simonvandel/AHA/README.md

# P5
