simonvandel/AHA/Report/frontpage.tex

%mainfile: master.tex
\begin{titlepage}
\begin{center}
\newcommand{\HRule}{\rule{\linewidth}{0.5mm}}

% Upper part of the page. The '~' is needed because \\
% only works if a paragraph has started.
~\\[1cm]

%\textsc{\LARGE Aalborg University}\\[1.5cm]

%\textsc{\Large Project Report}\\[0.5cm]
\vspace{2em}
% Title
\HRule \\[0.1cm]
{
\huge AHA\\\large\textsc{Automated Home Automation}\\
}

\HRule \\[1.5cm]

% Author and supervisor
\begin{minipage}{0.4\textwidth}
\begin{flushleft} \large
\textbf{Project Group}\\
\textsc{sw501e15}
\end{flushleft}
\end{minipage}
\begin{minipage}{0.4\textwidth}
\begin{flushright} \large
\textbf{Supervisor} \\
\textsc{Giovanni Bacci}
\end{flushright}
\end{minipage}

\vfill

% Bottom of the page
{\large December 21\textsuperscript{st}, 2015}

\end{center}
\end{titlepage}
