simonvandel/AHA/Report/Design/design.tex

\chapter{Design}\label{cha:design}

This chapter defines, in general terms, which subsystems are needed in order to fulfil the requirements described in the previous chapters.

\input{Design/architecture}
\input{Design/hardware}
\input{Design/ai}
\input{Design/normalizer}
\input{Design/sampler}
\input{Design/HMM}
\input{Design/reasoner}
