simonvandel/AHA/Report/Specification/PACT.tex

%mainfile: ../master.tex
\section{People, Activity, Context, and Technology Analysis}\label{sec:pact}
To establish a basis for defining the design requirements for this project and
to better understand the problem domain, a People, Activity, Context and Technology (PACT) analysis\cite{DEB} is done.

\subsection{People}\label{sub:people}
In an ideal situation the user should never be required to interact with the system. In a PACT-analysis when discussing people there are number of things that can be mentioned. In the following section we will go over a few and discuss their relevance.
Authors David Benyan, Phil Turner, Susan Turner\cite{DEB}, in BOX 22.7, propose that less than 100 ms (denoted <100 ms) is the timing required for a response to some interaction, in order for the response to be perceived by a person as being instant. This in turn means that in order for a person to perceive a response of an interaction performed by the system, as being the instant effect of the interaction, the response should be <100 ms. This knowledge poses the requirement that a full computation cycle of the system from input to response should be <100 ms.

\paragraph{Physical Abilities}
Since the system does not assume anything about the user, few physical characteristics matters. Some that might be relevant are certain disabilities. One type of disability which would matter to the system, is loss or deprecation of senses, such as blindness or hearing loss. This would impact the types of sensor data which is relevant for the system. For example, having a system which uses sound levels to determine its actions would not make sense if the system was implemented in the house of a deaf person.

\paragraph{Cognitive Abilities}
Various levels of cognitive ability encompass a wide variety of problems
when considering design. Assuming that the system is not flawless, in the
  sense that the system will perform wrong actions some of the time, how should
the system respond and inform the user of why the error happened? Another thing
to consider is how the user is presented with information regarding the status
of the system.

This is relevant to the psychological characteristics because the system needs to be designed so that, regardless of the users' technical capabilities, the users are able to use it.

Since the system is based on the usage patterns of the user, the system will not be recommended for people with personality disorders, such as schizophrenia, or people who are dependent on regularity, such as people with autism.

\subsection{Activities and Context}
The activity the system will focus on is turning on and off lights and
appliances. While this is not a time consuming task, it is done often. First the
system needs to learn users' patterns. This will not change how the user does
this activity, because the system will passively observe when and in what
context the lights or appliances are turned on.

There are a number of different
contexts when turning on appliances in a home may be relevant.
For example if the user drinks coffee in the morning, should the system then
start brewing coffee based on the time or movement in the home? Turning on
lights could also be context sensitive; for example lower levels of light
intensity in the morning or when the user is watching television.

The only time the user needs to directly interact with the system is when the system is doing something wrong. As part of the learning process the user is required to inform the system when some action is wrong. This requires one to consider how the system should present the decisions it makes to the user and allow the user to clearly define what actions were wrong.

\subsection{Technologies}
\label{sub:Technologies}
The technologies used for this type of system can be separated into three different areas, which define the purpose of technologies in the problem domain; input, output, and communication.
\subsubsection{Input}
The input can be split up into two different technology areas; sensors and general purpose interface.

The sensors are used to inform the system about the state of the problem domain. The problem domain of home automation is a diverse one since it depends on a human's habits, which is dependent on a variety of factors, such as the human's senses, their feelings, experiences and mood. Since it would be nearly impossible for a system of this type to detect a human's feelings, experiences or mood, the optimal amount of sensors is defined by being equivalent to the human senses. This as well is a very hard task to complete. Partly because it is not clear how many senses humans have; the amount varies depending on how senses are defined, and partly because each sense requires at least one sensor type. The delimitation of the problem domain makes the problem slightly simpler. Only senses used for lighting and appliance usage are needed. The senses concerning the habits of this area are found to be as follows:
\begin{itemize}
	\item Time
	\item Light intensity
	\item Location and spatial awareness
	\item Awareness of lights and appliances
  \item Awareness of the state of lights and appliances
\end{itemize}
The sensor variety needed to fully encompass the problem domain therefore needs to fulfil these areas, but variety is not everything. The perspective of the system is also different from that of the user. Since the system is stationary and the user moves around in the home, the system also need more sensors of the same type in order to emulate the users senses in all locations. This task is a bit harder to firmly put into numbers since it depends on how well the sensors operate; this could warrant some experiments, to measure the sensors' quality. Generally, it can be said that enough sensors are needed for the system to be able to detect the relevant information for the users' patterns, as well as being able to detect these information in a timely manner, such that the system can emulate the users' patterns.

\subsubsection{Output}
In all systems the output are the actuators. The actuators have to be able to mimic the actions the user are able to perform. Since the system focuses on lights and appliances it only needs to be able to:
\begin{itemize}
	\item Turn on/off the light
	\item Adjust the light up/down if possible
\end{itemize}
In the case of appliances a general list is not possible to create, since different appliances solve vastly different tasks. Luckily the appliances have well defined tasks that can be expressed formally and actuators have to be able to mimic the usage of the appliance. The actuators and sensors needed to for each specific device will be further expressed in the implementation section when needed.

\subsubsection{Communication}
As expressed earlier the system will be spread out over the home of the user. The sensors and actuators therefore need to be able to communicate with each other. The structuring of this can be found in \cref{sec:architecture}. Since the focus of this project is not on the communication, the technologies for this will follow the standards used within the established field of home automation.
