simonvandel/AHA/Report/Implementation/hardware.tex

\input{Implementation/pir}
\input{Implementation/pirExperiments}

\input{Implementation/photoResistor}
\input{Implementation/photoResistorExperiments}

\input{Implementation/ultrasonic}
