simonvandel/AHA/Report/Implementation/implementation.tex

%mainfile: ../master.tex
\chapter{Implementation}\label{part:implementation}

This chapter describes some implementations done on behalf of the architecture decision made in \cref{sec:architecture}. We will also describe and review some of the hardware employed in this project.

\input{Implementation/pir}
\input{Implementation/pirExperiments}
\input{Implementation/photoResistor}
\input{Implementation/photoResistorExperiments}
\input{Implementation/ultrasonic}
\input{Implementation/XBee/xbee}
\input{Implementation/encodingSchemes}
\input{Implementation/sensorStation}
