simonvandel/AHA/Report/Design/architecture.tex

%mainfile: ../master.tex
\section{System Architecture}\label{sec:architecture}

Overall the system has to perform three tasks.

\begin{itemize}
\item Data collection of events in the problem domain
\item Analysis of this data and inference of behavioural patterns. This is now referred to as the learning task
\item Mimic the inferred behavioural patterns learned during the learning procedure
\end{itemize}
This section discusses different architectural designs for the system.

\subsection{Variable Number of Sensors}
If the system was to support a variable number of sensors, the user has to add sensors and actuators to the system manually and inform the system about what they are, or alternatively require a technician to setup the system. This reduces usability.

If the setup is managed by the user, it is vulnerable to user mistakes, and would increase the barrier to entry. For example, consider the case where a PIR sensor is connected to the system, but the system believes the connected sensor to be a thermometer. The data received from the PIR sensor will most likely not make any sense, so the system will be based on a wrong model of the world.

\subsection{Fixed Number of Sensors}
If the system was to support a fixed number of sensors, the system is pre assembled with a fixed number of sensors and actuators and the user can simply not extend the system with more hardware. This solution does not consider the fact that all houses are different. Either there will be too many sensors in some houses, thereby consuming too much power compared to what is needed, or there will be too few sensors in some houses, meaning that the system will not be very effective and/or non existing in some rooms. This conflicts with the idea that the system should adapt to the working environment, and not vice versa.

\subsection{Monolithic System}
One possibility is to have one central processing unit that controls and reads data from all available sensors, sanitises and analyses it, decides which, if any, action to perform, and performs it via its actuators. This is illustrated in \cref{fig:monolithic_system}. A disadvantage to this architecture, is that it is not very resilient. If any part of the system crashes, the whole system is brought down with it.

\begin{figure}[htbp]
\centering
\begin{tikzpicture}
  %Nodes
  \node[squarednode] (mainController) {Sensor/actuator controller + data analyser};
  \node[squarednode] (sensor1) [above=of mainController] {Sensor 1};
  \node[squarednode] (sensor2) [below=of mainController] {Sensor 2};
  \node[squarednode] (actuator1) [right=of mainController] {Actuator 1};
  \node[squarednode] (actuator2) [left=of mainController] {Actuator 2};

  %Lines
  \path
    (mainController.north) edge (sensor1.south)
    (mainController.west) edge(actuator2.east)
    (mainController.east) edge (actuator1.west)
    (mainController.south) edge (sensor2.north);
\end{tikzpicture}
\caption[Monolithic system]{Illustration of a monolithic system. The central processing unit monitors the sensors and, at the same time, analyses the monitored sensor data.}\label{fig:monolithic_system}
\end{figure}

\subsection{Distributed System}
A second architecture tries to introduce modularity and ease of use, by distributing the sensors and actuators on several units. The system is comprised of multiple subsystems that each have a processing unit, which is aware of what sensors and actuators are connected to it. It is responsible for sanitising the sensor data and activating the actuators. They can communicate and combine their knowledge to get a complete model of the problem domain. See \cref{fig:distributed_system}.

\begin{figure}[htbp]
\centering
\begin{tikzpicture}
  %Nodes
  \node[squarednode] (controller1) {Sensor/actuator controller 1 + data analyser};
  \node[squarednode] (controller2) [right=of controller1, xshift=5em] {Sensor/actuator controller 2 + data analyser};
  \node[squarednode] (sensor1) [above=of controller1] {Sensor 1};
  \node[squarednode] (sensor2) [below=of controller1] {Sensor 2};
  \node[squarednode] (sensor3) [above=of controller2] {Sensor 3};
  \node[squarednode] (actuator1) [left=of controller1] {Actuator 1};
  \node[squarednode] (actuator2) [below=of controller2] {Actuator 2};

  %Lines
  \path
    (controller1.north) edge (sensor1.south)
    (controller1.west) edge (actuator1.east)
    (controller1.south) edge (sensor2.north)
    (controller2.north) edge (sensor3.south)
    (controller2.south) edge (actuator2.north)
    (controller1) edge[out=east,in=west,triangle 90-triangle 90] node[anchor=south] {Knowledge} (controller2);
\end{tikzpicture}
\caption[Distributed system]{Illustration of a distributed system. In this example, two controllers monitor their respective sensors and analyse the monitored data. The knowledge from the learning is shared among different controllers in the system.}\label{fig:distributed_system}
\end{figure}

The user can choose exactly the number of sensor/actuator units needed for the home. If the units are connected wirelessly, there only needs to be wired power to the unit, thereby reducing the barrier to entry.

This solution requires complex communication protocols among each individual sensor/actuator unit, in order to reliably combine their knowledge. Furthermore, the learning procedure is a complex task, see \cref{sec:functions}, that needs powerful hardware. This would mean that each unit would need to have powerful hardware, increasing power usage.

\subsection{Separated Subsystems}
A separation of data collection and actuation of tasks, and the learning procedure, is needed. In this architecture, a distributed system of small low-power processing units collect the sensor data and complete the actuation of tasks while the learning procedure is performed on a more powerful computation device.

Under this separation the system consists of three subsystems; sensor, actuator and the learning procedure. These subsystems might run on the same device. The general architecture can be seen in \cref{fig:separated_subsystems}.

\begin{figure}[htbp]
\centering
\begin{tikzpicture}
  %Nodes
  \node[squarednode] (sensorController) {Sensor controller};
  \node[squarednode] (learningController) [below right=of sensorController] {Learning controller};
  \node[squarednode] (actuatorController) [above right=of learningController] {Actuator controller};
  \node[squarednode] (sensor1) [above=of sensorController] {Sensor 1};
  \node[squarednode] (actuator1) [above=of actuatorController] {Actuator 1};

  %Lines
  \path
    (sensorController.north) edge (sensor1.south)
    (sensorController) edge[out=south,in=west] (learningController)
    (sensorController.east) edge (actuatorController.west)
    (actuatorController) edge[out=south,in=east] (learningController)
    (actuatorController.north) edge (actuator1.south);
\end{tikzpicture}
\caption[Separated system]{Illustration of a separated system. The sensor and actuator subsystem each consists of one controller, controlling one sensor and actuator respectively.}\label{fig:separated_subsystems}
\end{figure}

This solution has the advantage of allowing for variance in the number of sensors used, as well as calculating and storing the knowledge about the problem domain centrally, so there is no need to synchronise with other subsystems.

To form the complete system, some communication must take place between the subsystems. There are different possible communication schemes.

\subsubsection{Communication Scheme 1}

In this scheme, the sensor subsystem sends its sensor data to the learning subsystem to be analysed and to match for behavioural patterns. When sensor data matches a certain behavioural pattern, an action is sent to the actuator subsystem, to be immediately performed.  The scheme is illustrated in \cref{fig:separated_subsystems_scheme1}.

\begin{figure}[htbp]
\centering
\begin{tikzpicture}[->]
  %Nodes
  \node[squarednode] (sensorSubsystem) {Sensor subsystem};
  \node[squarednode] (learningSubsystem) [below right=of sensorSubsystem] {Learning subsystem};
  \node[squarednode] (actuatorSubsystem) [above right=of learningSubsystem] {Actuator subsystem};

  %Lines
  \path[-triangle 90]
    (sensorSubsystem) edge[out=south,in=west] node[anchor=east] {sensor data} (learningSubsystem)
    (learningSubsystem) edge[out=east,in=south] node[anchor=west] {action} (actuatorSubsystem);
\end{tikzpicture}
\caption[Communication scheme 1]{Illustration of communication scheme 1 for a separated system.}\label{fig:separated_subsystems_scheme1}
\end{figure}

\subsubsection{Communication Scheme 2}

This scheme is similar to scheme 1, but instead of the learning subsystem sending actions to the actuator subsystem, rules are sent. A rule specifies when an action should be performed. This rule can depend on multiple sensor values. In order for the actuator subsystem to use the rules, sensor data is needed. Therefore the sensor subsystem also sends its sensor data to the actuator subsystem. See \cref{fig:separated_subsystems_scheme2} for a visual representation.

\begin{figure}[htbp]
\centering
\begin{tikzpicture}
  %Nodes
  \node[squarednode] (sensorSubsystem) {Sensor subsystem};
  \node[squarednode] (learningSubsystem) [below right=of sensorSubsystem] {Learning subsystem};
  \node[squarednode] (actuatorSubsystem) [above right=of learningSubsystem] {Actuator subsystem};

  %Lines
  \path[-triangle 90]
  (sensorSubsystem) edge[out=south,in=west] node[anchor=east] {sensor data} (learningSubsystem)
  (sensorSubsystem) edge[out=east,in=west] node[anchor=south] {sensor data} (actuatorSubsystem)
  (learningSubsystem) edge[out=east,in=south] node[anchor=west] {rules} (actuatorSubsystem);
\end{tikzpicture}
\caption[Communication scheme 2]{Illustration of communication scheme 2 for a separated system.}\label{fig:separated_subsystems_scheme2}
\end{figure}

\subsubsection{Communication Scheme 3}

The difference between scheme 3 and 2 is that the sensor and actuator subsystems have been merged. See \cref{fig:separated_subsystems_scheme3}. This means that sensors and actuators can be connected to the same controller, reducing the latency for communicating sensor data between actuators and sensors.

\begin{figure}[htbp]
\centering
\begin{tikzpicture}
  %Nodes
  \node[squarednode] (sensorActuatorSubsystem) {Sensor/Actuator subsystem};
  \node[squarednode] (learningSubsystem) [right=of sensorActuatorSubsystem, xshift=5em] {Learning subsystem};

  %Lines
  \draw[-triangle 90, transform canvas={yshift=2mm}] (sensorActuatorSubsystem.east) -- node[anchor=south] {sensor data} (learningSubsystem.west);
  \draw[-triangle 90] (sensorActuatorSubsystem) to [out=255,in=295, looseness=8] node[anchor=north] {sensor data} (sensorActuatorSubsystem);
  \draw[-triangle 90, transform canvas={yshift=-2mm}] (learningSubsystem.west) -- node[anchor=north] {rules} (sensorActuatorSubsystem.east);
\end{tikzpicture}
\caption[Communication scheme 3]{Illustration of communication scheme 3 for a separated system.}\label{fig:separated_subsystems_scheme3}
\end{figure}

\subsubsection{Communication Scheme 4}

As in scheme 3, the sensor and actuator subsystems have been merged. The learning subsystem receives sensor data from the sensor subsystem and generates actions based on behavioural patterns. Actions are sent back to be performed. See \cref{fig:separated_subsystems_scheme4}.

\begin{figure}[htbp]
\centering
\begin{tikzpicture}
  %Nodes
  \node[squarednode] (sensorActuatorSubsystem) {Sensor/Actuator subsystem};
  \node[squarednode] (learningSubsystem) [right=of sensorActuatorSubsystem, xshift=5em] {Learning subsystem};

  %Lines
  \draw[-triangle 90, transform canvas={yshift=2mm}] (sensorActuatorSubsystem.east) -- node[anchor=south] {sensor data} (learningSubsystem.west);
  \draw[-triangle 90, transform canvas={yshift=-2mm}] (learningSubsystem.west) -- node[anchor=north] {action} (sensorActuatorSubsystem.east);
\end{tikzpicture}
\caption[Communication scheme 4]{Illustration of communication scheme 4 for a separated system.}\label{fig:separated_subsystems_scheme4}
\end{figure}

\subsubsection{Communication Scheme 5}

Sensor data is sent to the learning subsystem to be analysed for patterns. Behavioural rules are sent to the sensor subsystem. If a rules matches the current sensor data, an action is dispatched to the actuator subsystem to be immediately performed. See \cref{fig:separated_subsystems_scheme5}.

\begin{figure}[htbp]
\centering
\begin{tikzpicture}
  %Nodes
  \node[squarednode] (sensorSubsystem) {Sensor subsystem};
  \node[squarednode] (learningSubsystem) [below=of sensorSubsystem, yshift=-3em] {Learning subsystem};
  \node[squarednode] (actuatorSubsystem) [right=of sensorSubsystem, xshift=5em] {Actuator subsystem};

  %Lines
  \draw[-triangle 90, transform canvas={xshift=2mm}] (sensorSubsystem.south) -- node[anchor=west] {sensor data} (learningSubsystem.north);
  \draw[-triangle 90] (sensorSubsystem) -- node[anchor=north] {action} (actuatorSubsystem);
  \draw[-triangle 90, transform canvas={xshift=-2mm}] (learningSubsystem.north) -- node[anchor=east] {rules} (sensorSubsystem.south);
\end{tikzpicture}
\caption[Communication scheme 5]{Illustration of communication scheme 5 for a separated system.}\label{fig:separated_subsystems_scheme5}
\end{figure}

\subsection{Choice of Architecture}

Given the above architectural designs, the monolithic design lacks in reliance. The distributed design allows for greater reliance, but at the cost of the need for a complex synchronisation mechanism to make the different subsystems share their knowledge. The separated designs described above allows for greater reliance, as well as avoiding complex synchronisation between the subsystems. Therefore the separated design seems the most appropriate choice.

Many communication schemes have been discussed. This section will evaluate the schemes by comparing each of them based on the following prioritised list of properties, to find the most fitting scheme for our system.

\begin{enumerate}
\item \textbf{Number of critical communication paths.} A path is critical if the data communicated is important or has to satisfy strict real-time constraints. If a scheme has fewer critical communication paths, the system is less likely to fail, and the system will be more responsive
\item \textbf{Memory consumption on actuator and sensor subsystems.} As the actuator and sensor subsystems should be based on an embedded systems to reduce the size and power usage, the available amount of memory is limited
\item \textbf{Amount of communication.} The less time spent communicating, the more time can be spent on other activities, such as reading output of sensors. If too much time is spent on communication, it could mean that some deadlines are not met
\item \textbf{Memory consumption on learning subsystem.} In order for the learning subsystem to be able to reason about sensor data, the hardware can be more powerful, so it is not important to consider this property
\end{enumerate}

\subsubsection{Scheme 1 Evaluation}
\begin{itemize}
\item \textbf{Number of critical communication paths} This scheme has 1 critical communication path; from the learning subsystem to the actuator subsystem. If this action package is lost or slow, the system will be perceived as unresponsive or unreliable
\item \textbf{Memory consumption on actuator and sensor subsystems} Nothing needs to be stored on the actuator and sensor subsystems
\item \textbf{Amount of communication} The sensor subsystem sends sensor data very often. The learning subsystem sends actions when certain sensor value conditions are met
\item \textbf{Memory consumption on learning subsystem} The learning subsystem has to store the history of all sensor data received
\end{itemize}

\subsubsection{Scheme 2 Evaluation}
\begin{itemize}
\item \textbf{Number of critical communication paths} The path from learning to actuator path is critical in the sense that if the packet is lost, the actuator will not have received the rule, and can therefore not perform any actions. The path from sensor subsystem to actuator subsystem is already critical in the sense that the path must happen quickly in order for the system to be responsive. If the sensor data takes a long time to arrive to the actuator subsystem, the actuator will take a long time to perform an action
\item \textbf{Memory consumption on actuator and sensor subsystems} The actuator subsystem has to store rules it receives from the learning subsystem
\item \textbf{Amount of communication} The sensor subsystem to learning subsystem communication path happens often. The sensor subsystem to actuator subsystem also happens often. The learning subsystem to actuator subsystem path is only used when a new rule is generated, which should not be often
\item \textbf{Memory consumption on learning subsystem} This is the same as in scheme 1
\end{itemize}

\subsubsection{Scheme 3 Evaluation}
This has the same characteristic as scheme 2, but the critical path from sensor subsystem to actuator subsystem is more reliable as the sensors and actuators are on the same controller.

\subsubsection{Scheme 4 Evaluation}
This scheme has the same characteristics as scheme 1, but the sensor and actuator subsystems are merged.

\subsubsection{Scheme 5 Evaluation}
\begin{itemize}
\item \textbf{Number of critical communication paths} The sensor subsystem to actuator subsystem communication path is critical, because if the packet is lost or slow, it will impact the responsiveness of the system. The learning subsystem to sensor subsystem communication path is critical because if rules are lost, the system can be perceived to malfunction
\item \textbf{Memory consumption on actuator and sensor subsystems} The sensor subsystem has to store rules
\item \textbf{Amount of communication} The sensor subsystem to learning subsystem communication path occurs often. The learning subsystem to sensor subsystem communication path is only used when new rules are generated. The sensor subsystem to actuator subsystem occurs every time an action is to be performed, which could happen fairly often
\item \textbf{Memory consumption on learning subsystem} This is the same as in scheme 1
\end{itemize}

\subsubsection{Conclusion}
Scheme 4 is chosen because of the following factors.
\begin{itemize}
\item It has only one critical communication path
\item The memory consumption on the embedded systems is minimal, so no limitation on rules is imposed on the system
\end{itemize}

Rule based schemes need many communication paths, which is not preferable according the above list of properties. The sensor/actuator subsystem is referred to as the embedded subsystem hereinafter.
