simonvandel/AHA/Report/Design/hardware.tex

\section{Hardware}
As decided in \cref{sec:architecture}, the system should consist of 2 subsystems: an embedded subsystem and a learning subsystem. This section will summarise the hardware requirements for the 2 subsystems, and at the end choose which hardware is suitable choices.

\input{Design/communication}

\subsubsection{Embedded Subsystem}
The embedded subsystem consists of sensors, actuators and computational devices driving the sensors and actuators. \Cref{sec:requirements} lists some properties that the system should be able to monitor. \Cref{sec:architecture} specifies requirements for the computational devices driving the sensors and actuators. The following sections discuss different hardware components that could fulfil the requirements.
\subsubsection{Sensors/Actuators}
\paragraph{Time}
Time can be measured using a real-time clock component. This component is driven by its own battery, so it can run, regardless of whether the hardware platform it is connected to, has power.

An alternative method of keeping track of time is by using an internal clock on the hardware platform that controls the sensors and actuators. This clock will only work when the platform has power. This means that every time the hardware platform is started, the clock is reset, so the correct time has to be determined.

In the context of this system, it is important that every component of the system has the same notion of time. The time has to be synchronised between all subsystems. This is true even for the real-time clock components, as even a slight drift in time would result in different notions of time across the whole system. One can therefore argue that the persistence property of a real-time clock is not needed. An internal clock in the hardware platform is adequate, as long as it is synchronised sufficiently often with other devices in the system.

Another solution for handling time, is to record the time messages are received on the learning subsystem. That way, only one clock is used, so there is no need for synchronisation. This means that the hardware in the learning subsystem needs to have a clock.

\paragraph{Light Intensity}
To measure light intensity, photoresistors are often chosen because of their small size and low cost. These properties fit the requirements of the system very well. In this project, the \enquote{VT90N2} photoresistor is chosen, because of its availability. Further information and experiments can be found in \cref{sub:photoresistor}.

\paragraph{Spatial Awareness}
The movement of the user can be determined by a motion sensor. One example of a motion sensor is a passive infrared sensor (PIR). These type of sensors are small in size, and low in cost. The specific PIR sensor used in this project is \enquote{SEN32357P}, because of its availability. Additional information and experiments on this sensor can be found in \cref{sub:pir}.

The location of the user can be detected by a distance sensor. In this project, ultrasound distance sensors will be used. The sensor is small in size, and does not cost much. The specific component used has the part number \enquote{HC-SR04}. It was chosen because of its availability and cost. See \cref{sub:ultrasonic} for more information and experiments.

\paragraph{Awareness of Active Appliances}
To determine whether a given appliance is turned on, one can measure the number of watts it draws. A wattmeter can do this.

\paragraph{Control of Lighting and Appliances}
To control lighting and appliances, one has to have a way to conditionally allow current to flow. This can be achieved with a relay. However, in this project, relays will not be used. Instead, a simple Light Emitting Diode (LED) that can be turned on and off which will represent lighting and appliances.

\subsubsection{Embedded Platform}
\paragraph{Input/Output Pins}
The computational device, controlling the sensors and actuators, has to have sufficient number of pins for connecting said sensors and actuators.

\paragraph{Computational Performance}
The chosen architecture for the system, as described in \cref{sec:architecture}, requires the hardware to be fast enough to be able to read all sensors, encode a package, send the package to the learning subsystem, and check whether it has received any actions from the learning subsystem. All of this has to happen within 100 ms, as described in \cref{sub:people}.

\paragraph{Scheduling Options}
In \cref{sec:architecture}, the chosen architecture describes that the embedded subsystem has two functions: Control its sensors and communicate sensor data to other devices. To precisely control when actions happen on the platform, it should be possible to manually schedule tasks to run.

\paragraph{Price}
The conclusion of the analysis, as described in \cref{sec:requirements}, lists price as an important criteria.

\paragraph{Energy Efficiency}
\Cref{sec:requirements} lists energy efficiency as an important property the system should have. This means that the hardware platform controlling the sensors and actuators has to consume a small amount of energy while in use.

\paragraph{Choice of Hardware Platform}
Arduino Uno boards are chosen for controlling the sensors and actuators. The Arduino boards were already available, so no hardware was needed to be purchased. However, the Arduino Unos also fulfil all the above requirements for the hardware platform.

\subsubsection{Learning Subsystem}
The following section lists the hardware requirements for the learning subsystem.

\paragraph{Computational Performance}
The subsystem has to be powerful enough to be able to decide which actions to perform, if any, based on the sensor data received from the embedded subsystem. The deadline for this is described in \cref{sub:people}. The hardware platform used in the embedded subsystem is not powerful enough to perform these computations in reasonable time. Therefore more powerful hardware is needed.

\paragraph{Input/Output Pin Availability}
The learning subsystem has to have accessible input and output pins in order to attach radio modules to the learning computational device.

\paragraph{Choice of Hardware}
A consumer laptop is chosen as the hardware of choice for the learning subsystem because it was already available. It is estimated to be powerful enough to compute the required computations in reasonable time.
