simonvandel/AHA/Report/Design/AIArchitecture.tex

%mainfile: ../master.tex
\Cref{sec:architecture} describes the overall architecture of the system, which solves the three tasks; data collection, learning and mimicking patterns learned from the learning procedure. This section will expand on the architecture designed to perform the second and third task, that is the learning subsystem of the system.

% DRAWING
\begin{figure}[htbp]
\centering
\begin{tikzpicture}
  %Nodes
  \node[squarednode] (embeddedSubsystem) {Embedded subsystem};
  \node[squarednode] (communication) [right=of embeddedSubsystem, xshift=5em] {Communication};
  \node[squarednode] (normaliser) [right=of communication, xshift=5em] {Normaliser};
  \node[squarednode] (reasoner) [below=of embeddedSubsystem, yshift=-3em] {Reasoner};
  \node[squarednode] (modelDatabase) [below=of reasoner, yshift=-3em] {Model Database};
  \node[squarednode] (sampler) [below=of normaliser, yshift=-3em] {Sampler};
  \node[squarednode] (historyDatabase) [below=of sampler, yshift=-3em] {History Database};
  \node[squarednode] (learner) [right=of modelDatabase, xshift=5em] {Learner};

  %Lines
  \path[-triangle 90]
  (embeddedSubsystem.east) edge[transform canvas={yshift=-1em}] node[anchor=north] {sensor data} (communication.west)
  (communication.west) edge[transform canvas={yshift=1em}] node[anchor=south] {actions} (embeddedSubsystem.east)
  (communication.east) edge node[anchor=south] {snapshot, time} (normaliser)
  (normaliser.south) edge node[anchor=east,text width=6em] {normalised snapshot, time} (sampler.north)
  (sampler.south) edge node[anchor=east,text width=6em] {scope, time, actions} (historyDatabase.north)
  (historyDatabase.west) edge node[anchor=south, text width=6em] {scope, time, actions} (learner.east)
  (learner.west) edge node[anchor=south] {model} (modelDatabase.east)
  (sampler.west) edge node[anchor=south, text width=6em] {scope, time, actions} (reasoner.east)
  (modelDatabase.north) edge[transform canvas={xshift=-1em}] node[anchor=east] {model} (reasoner.south)
  (reasoner) edge[out=north,in=south] node[anchor=north] {actions} (communication)
  (reasoner.south) edge[transform canvas={xshift=1em}] node[anchor=west] {feedback} (modelDatabase.north);
\end{tikzpicture}
\caption[Learning architecture]{Overview of the modules in the learning architecture.}\label{fig:learning_architecture}
\end{figure}

As can be seen from \cref{fig:learning_architecture}, the learning subsystem contains six modules; communication, normaliser, sampler, database, learner and reasoner. The rationale of this particular architecture and its modules is explained in the following. The term \emph{snapshot} is used to describe the set of the values of all sensors at a time. For example, in a system with two sensors $S1,S2$, a snapshot at time $t$ is a particular instance of the values of the sensors, e.g. $S1=1, S2=0$.

\subsection{Communication}
The input to the learning subsystem is a stream of packets. These packets of sensor values arrive continuously, as devices from the embedded subsystem send them. The communication module handles these packets and also provides functionality to send data to devices in the learning subsystem. When sensor values arrive at the communication module, the data of the packet is encoded in the binary format described in \cref{sec:encoding}. The communication module decodes the binary data and notes the time the packet was received.

When sensor values have been received from all learning stations, the decoded sensor values and the time of arrival (the arrival time of the newest sensor value) is then sent to the normaliser. This collection of sensor values are henceforth called snapshots.

\subsection{Normaliser}
To remove noise from the sensors and to reduce the size of the problem, a normalisation pass is performed on the input. The normalisation pass is explained deeper in \cref{sec:normaliser}. The output of the normalisation is the same set of sensor values, but normalised to fit into a domain of size \emph{k}. The time of arrival is not normalised.

The normalised snapshots and the times of arrival are then fed to the sampler.

\subsection{Sampler}
This module performs three tasks:

\begin{enumerate}
\item It connects snapshots with the previous \emph{n} snapshots. The previous \emph{n} snapshots represent the history of the snapshot fed to the sampler. Together the current snapshot and its history of snapshots form a state scope
\item It calculates whether an action has occurred from the previous snapshot to the current. An action has occurred when one or more emulatable sensors have changed its value
\item It hashes the state scope
\end{enumerate}

The hashed state scopes and the calculated action, as well as the time of arrival, is now sent to two modules; the database and the reasoner.

\subsection{Database}
The database has the responsibility to store the learned model used for predicting user patterns, as well as storing samples of data observed from the sensors.

\subsection{Learner}
The responsibility of the learner is to infer the best parameters of the model. This is further described in \cref{sec:learner}. The learner will utilise the samples stored in the database. When parameters for a model has been learned, the model is stored in the database, for others to consume.

\subsection{Reasoner}
The reasoner should, based on the model retrieved from the database and the current scope, time, and actions, infer which actions the user wants performed.
