simonvandel/AHA/Report/Implementation/UltrasonicPlots/plot0angle.tex

%sensor 1
\addplot[color=red,mark=square]
  coordinates {
              (0,5)
              (1,2)
              (2,2)
              (3,3)
              (4,4)
              (5,5)
              (10,10)
              (20,20)
              (40,39)
              (80,78)
              (160,157)
              (320,313)
              (450,445)
              (570,565)
  };
  \addlegendentry{Sensor 1}
%sensor 2
\addplot[color=red,mark=star]
  coordinates {
              (0,5)
              (1,2)
              (2,2)
              (3,3)
              (4,4)
              (5,5)
              (10,10)
              (20,20)
              (40,39)
              (80,78)
              (160,157)
              (320,313)
              (450,445)
              (600,595)
  };
  \addlegendentry{Sensor 2}
%sensor 3
\addplot[color=red,mark=triangle]
  coordinates {
              (0,4)
              (1,2)
              (2,2)
              (3,3)
              (4,4)
              (5,5)
              (10,10)
              (20,20)
              (40,39)
              (80,79)
              (160,157)
              (320,315)
              (450,446)
              (570,566)
  };
  \addlegendentry{Sensor 3}
