simonvandel/AHA/Report/Implementation/UltrasonicPlots/plot0cm.tex

%sensor 1
\addplot[color=red,mark=square]
  coordinates {
              (0,5)
  };
%sensor 2
\addplot[color=red,mark=circle]
  coordinates {
              (0,5)
  };
%sensor 3
\addplot[color=red,mark=triangle]
  coordinates {
              (0,4)
  };
