simonvandel/AHA/Report/Implementation/UltrasonicPlots/plot10cm.tex

%sensor 1
\addplot[color=red,mark=square]
  coordinates {
              (10,10)
              (10,10)
              (10,9)
  };
%sensor 2
\addplot[color=red,mark=circle]
  coordinates {
              (10,10)
              (10,10)
  };
%sensor 3
\addplot[color=red,mark=triangle]
  coordinates {
              (10,10)
              (10,10)
  };
