simonvandel/AHA/Report/Implementation/UltrasonicPlots/plot160cm.tex

%sensor 1
\addplot[color=red,mark=square]
  coordinates {
              (160,157)
              (160,154)
              (160,148)
              (160,137)
  };
%sensor 2
\addplot[color=red,mark=circle]
  coordinates {
              (160,157)
  };
%sensor 3
\addplot[color=red,mark=triangle]
  coordinates {
              (160,157)
  };
