simonvandel/AHA/Report/Implementation/UltrasonicPlots/plot1cm.tex

%sensor 1
\addplot[color=red,mark=square]
  coordinates {
              (1,2)
              (1,2)
              (1,2)
              (1,2)
  };
%sensor 2
\addplot[color=red,mark=circle]
  coordinates {
              (1,2)
              (1,2)
  };
%sensor 3
\addplot[color=red,mark=triangle]
  coordinates {
              (1,2)
              (1,2)
  };
