simonvandel/AHA/Report/Implementation/UltrasonicPlots/plot20cm.tex

%sensor 1
\addplot[color=red,mark=square]
  coordinates {
              (20,20)
              (20,20)
              (20,19)
  };
%sensor 2
\addplot[color=red,mark=circle]
  coordinates {
              (20,20)
              (20,20)
  };
%sensor 3
\addplot[color=red,mark=triangle]
  coordinates {
              (20,20)
              (20,20)
  };
