simonvandel/AHA/Report/Implementation/UltrasonicPlots/plot2cm.tex

%sensor 1
\addplot[color=red,mark=square]
  coordinates {
              (2,2)
              (2,2)
              (2,3)
              (2,3)
              (2,3)
  };
%sensor 2
\addplot[color=red,mark=circle]
  coordinates {
              (2,2)
              (2,2)
  };
%sensor 3
\addplot[color=red,mark=triangle]
  coordinates {
              (2,2)
              (2,2)
  };
