simonvandel/AHA/Report/Implementation/UltrasonicPlots/plot320cm.tex

%sensor 1
\addplot[color=red,mark=square]
  coordinates {
              (320,313)
  };
%sensor 2
\addplot[color=red,mark=circle]
  coordinates {
              (320,313)
  };
%sensor 3
\addplot[color=red,mark=triangle]
  coordinates {
              (320,315)
  };
