simonvandel/AHA/Report/Implementation/UltrasonicPlots/plot3cm.tex

%sensor 1
\addplot[color=red,mark=square]
  coordinates {
              (3,3)
              (3,3)
              (3,3)
              (3,3)
              (3,4)
  };
%sensor 2
\addplot[color=red,mark=circle]
  coordinates {
              (3,3)
              (3,3)
  };
%sensor 3
\addplot[color=red,mark=triangle]
  coordinates {
              (3,3)
              (3,3)
  };
