simonvandel/AHA/Report/Implementation/UltrasonicPlots/plot40cm.tex

%sensor 1
\addplot[color=red,mark=square]
  coordinates {
              (40,39)
              (40,39)
              (40,38)
  };
%sensor 2
\addplot[color=red,mark=circle]
  coordinates {
              (40,39)
              (40,39)
  };
%sensor 3
\addplot[color=red,mark=triangle]
  coordinates {
              (40,39)
              (40,39)
  };
