simonvandel/AHA/Report/Implementation/UltrasonicPlots/plot450cm.tex

%sensor 1
\addplot[color=red,mark=square]
  coordinates {
              (450,445)
  };
%sensor 2
\addplot[color=red,mark=circle]
  coordinates {
              (450,445)
  };
%sensor 3
\addplot[color=red,mark=triangle]
  coordinates {
              (450,446)
  };
