simonvandel/AHA/Report/Implementation/UltrasonicPlots/plot4cm.tex

%sensor 1
\addplot[color=red,mark=square]
  coordinates {
              (4,4)
              (4,4)
              (4,4)
              (4,4)
              (4,4)
  };
%sensor 2
\addplot[color=red,mark=circle]
  coordinates {
              (4,4)
              (4,4)
  };
%sensor 3
\addplot[color=red,mark=triangle]
  coordinates {
              (4,4)
              (4,4)
  };
