simonvandel/AHA/Report/Implementation/UltrasonicPlots/plot570cm.tex

%sensor 1
\addplot[color=red,mark=square]
  coordinates {
              (570,565)
  };
%sensor 3
\addplot[color=red,mark=triangle]
  coordinates {
              (570,566)
  };
