simonvandel/AHA/Report/Implementation/UltrasonicPlots/plot5cm.tex

%sensor 1
\addplot[color=red,mark=square]
  coordinates {
              (5,5)
              (5,5)
              (5,5)
              (5,5)
              (5,6)
  };
%sensor 2
\addplot[color=red,mark=circle]
  coordinates {
              (5,5)
              (5,5)
  };
%sensor 3
\addplot[color=red,mark=triangle]
  coordinates {
              (5,5)
              (5,5)
  };
