simonvandel/AHA/Report/Implementation/UltrasonicPlots/plot600cm.tex

%sensor 2
\addplot[color=red,mark=circle]
  coordinates {
              (600,595)
  };
