simonvandel/AHA/Report/Implementation/UltrasonicPlots/plot80cm.tex

%sensor 1
\addplot[color=red,mark=square]
  coordinates {
              (80,78)
              (80,77)
              (80,74)
  };
%sensor 2
\addplot[color=red,mark=circle]
  coordinates {
              (80,78)
  };
%sensor 3
\addplot[color=red,mark=triangle]
  coordinates {
              (80,79)
  };
