simonvandel/AHA/ExamPresentation/slides/Rasmus.tex

\section{Embedded system implementation}
\subsection{Embedded Subsystem}
  \begin{frame}
	\frametitle{Phases in the Embedded Subsystem}
  	\begin{itemize}
  		\item poll sensors
  		\item encode
  		\item send
  		\item wait for action
        \begin{itemize}
            \item performing the action
        \end{itemize}
  	\end{itemize}
  \end{frame}

\subsubsection{Communication}
  \begin{frame}
  	\frametitle{ZigBee}
  	\begin{itemize}
  		\item ZigBee is low power, low latency, and cheap
  		\item ZigBee AT vs ZigBee API
        \begin{itemize}
            \item using ZigBee API
        \end{itemize}
  		\item difficulty making it work
        \begin{itemize}
            \item poor understanding, scarce in-depth documentation
            \item cheap hardware - low end module
            %Did we jump head first? should we jump head first in, or do more research first?
        \end{itemize}
  	\end{itemize}
  \end{frame}

\subsubsection{Encoding}
  \begin{frame}
  	\frametitle{Encoding}
  	\begin{itemize}
        \item Implementation 
    	\begin{itemize}
            \item buffer of 64 bytes
            \item keeps track of which byte, and which bit within that byte
            \item a call to the add function with parameters (4, 6):
            \begin{itemize}
                \item if enough bits are left in current byte "001000" are shifted onto the byte
                \item if not enough bits are left, available are filled and add function called recursively
                \item assume 3 bits are available in current byte shift "001" and call add on (0, 3)
            \end{itemize}            
        \end{itemize}
    \end{itemize}          	
  \end{frame}

\begin{frame}
	\frametitle{Encoding}
    \begin{itemize}
        \item implementation
		\item why did we make our own encoding?
        \begin{itemize}
            \item ZigBee interaction we can't explain
            \item flexibility, size
        \end{itemize}
    \end{itemize}
\end{frame}
