simonvandel/AHA/ExamPresentation/slides/Fuglsang.tex

\section{System Overview}
\subsection{System Specification}
\begin{frame}
	\frametitle{System Specification}
	The system should
	\begin{itemize}
	\item be able to control lighting and electronic appliances
	\item be able to learn usage patterns of users, in such a way that their usage patterns are automated
	\item be entirely wireless
	\item be conservative in its actions
	\item be able to recognise whether an action is a temporary adjustment or a permanent change in schedule
	\item minimise user interaction
	\end{itemize}
\end{frame}

\subsection{Architecture}
\begin{frame}
	\frametitle{Architecture}
  \begin{figure}[htbp]
    \centering
    \begin{tikzpicture}
        %Nodes
        \node[squarednode] (sensorActuatorSubsystem) {Embedded subsystem};
        \node[squarednode] (learningSubsystem) [right=of sensorActuatorSubsystem, xshift=5em] {Learning subsystem};

        %Lines
        \draw[-triangle 90, transform canvas={yshift=2mm}] (sensorActuatorSubsystem.east) -- node[anchor=south] {sensor data} (learningSubsystem.west);
        \draw[-triangle 90, transform canvas={yshift=-2mm}] (learningSubsystem.west) -- node[anchor=north] {action} (sensorActuatorSubsystem.east);
    \end{tikzpicture}
    \caption{General overview of the system}
  \end{figure}
\end{frame}

\begin{frame}
	\frametitle{Architecture}
  \begin{figure}[htbp]
  \centering
  \begin{tikzpicture}[scale=0.6, every node/.style={transform shape}]
    %Nodes
    \node[squarednode] (embeddedSubsystem) {Embedded subsystem};
    \node[squarednode] (communication) [right=of embeddedSubsystem, xshift=5em] {Communication};
    \node[squarednode] (normaliser) [right=of communication, xshift=5em] {Normaliser};
    \node[squarednode] (reasoner) [below=of embeddedSubsystem, yshift=-3em] {Reasoner};
    \node[squarednode] (sampler) [below=of normaliser, yshift=-3em] {Sampler};
    \node[squarednode] (learner) [below=of reasoner, yshift=-2em] {Learner};

    %Lines
    \path[-triangle 90]
    (embeddedSubsystem.east) edge[transform canvas={yshift=-0.5em}] node[anchor=north] {sensor data} (communication.west)
    (communication.west) edge[transform canvas={yshift=0.5em}] node[anchor=south] {actions} (embeddedSubsystem.east)
    (communication.east) edge node[anchor=south] {snapshot, time} (normaliser)
    (normaliser.south) edge node[anchor=east,text width=6em] {normalised snapshot, time} (sampler.north)
    (sampler) edge[out=south, in=east] node[anchor=north,text width=6em] {scope, time, actions}  (learner)
    (learner) edge[out=north, in=south, transform canvas={xshift=-1em}] node[anchor=east] {model} (reasoner)
    (sampler.west) edge node[anchor=south, text width=6em] {scope, time, actions} (reasoner.east)
    (reasoner) edge[out=north,in=south] node[anchor=north] {actions} (communication)
    (reasoner) edge[out=south,in=north, transform canvas={xshift=1em}] node[anchor=west] {feedback} (learner);
  \end{tikzpicture}
  \caption{Detailed overview of the system}
  \end{figure}
\end{frame}
