simonvandel/AHA/Report/master.tex

\input{preamble.tex}
\begin{document}
  %\listoffixmes
  \include{frontpage}
  \include{colophon}
  \pdfbookmark[0]{Title Page}{label:Titlepage}
  \include{titlepage}
	\blankpage

  \pdfbookmark[0]{\contentsname}{label:Contents}
  \setcounter{tocdepth}{2}
	\pagestyle{empty}
  % \listoffixmes
  \tableofcontents
  \listoffigures
  \begingroup
  \let\clearpage\relax
  \listoftables
  \endgroup
	\clearpage
	\pagestyle{BasicStyle}

  \pagenumbering{arabic}
  \include{preface}\thispagestyle{empty}
  \blankpage
  \include{introduction}
  \include{Analysis/analysis}
  \include{Specification/specification}
  \include{Design/design}
  \include{Implementation/implementation}
  \include{Verification/verification}
  \include{conclusion}
  \include{future}
  \pdfbookmark[0]{Bibliography}{label:Bibliography}
  \printbibliography

  \include{appendix}

\end{document}
