simonvandel/AHA/Report/preamble.tex

\synctex=1

\documentclass[a4paper,12pt,english,twoside]{report}

%%%% PACKAGES %%%%

\usepackage[table]{xcolor}
\usepackage[T1]{fontenc}
\usepackage[utf8]{inputenc} % encoding=utf8
\usepackage{fourier} % font
\usepackage{amssymb}
\usepackage{amsmath}
\usepackage{pifont}
\usepackage[english]{babel} % language support - hyphenations etc.
\usepackage{graphicx} % insertion of images
\usepackage{adjustbox}
\graphicspath{ {Images/}}
\usepackage{adjustbox}
\usepackage{listings} % source code
\usepackage{color}
%itemize spacing
\usepackage{enumitem}
\setlist[1]{itemsep=-5pt}
\usepackage[noend]{algpseudocode}
\usepackage{algorithmicx}
\usepackage{algorithm}
\usepackage{tikz}
\usepackage[simplified]{pgf-umlcd}
\usepackage{epigraph}
\usetikzlibrary{calc,arrows,positioning,shapes,snakes}

\setlength\epigraphwidth{15cm}
\setlength\epigraphrule{0pt}

\addtocontents{toc}{\setcounter{tocdepth}{1}}% Allow \section in ToC

\tikzset{
squarednode/.style={
  rectangle,
  draw=black,
  text width=8em,
  minimum height=3em,
  align=center,
  }
}
\renewcommand{\association}[6]{
\draw [umlcd style] (#1) -- (#4)
node[very near start, above]{#2}
node[very near start, above right]{#3}
node[very near end, above right]{#5}
node[very near end, below]{#6};
}

\renewcommand{\aggregation}[4]
{
\draw[umlcd style, open diamond-] (#1) -- (#4)
node[very near end, above]{#2}
node[very near end, below]{#3};
}
\renewcommand{\composition}[4]
{
\draw[umlcd style, fill=\umldrawcolor, diamond-] (#1) -- (#4)
node[very near end, above]{#2}
node[very near end, below]{#3};
}

\renewcommand{\unidirectionalAssociation}[4]{
\draw [umlcd style, -] (#1) -- (#4)
node[very near end, above]{#2}
node[very near end, below]{#3};
}

\usepackage{pgfplots} % for plotting graphs
\usepackage{textcomp}
\usepackage{siunitx}
\usepackage[inference]{semantic}
\usepackage{braket}
\usepackage{array}
\usepackage[nounderscore]{syntax}
\usepackage{gensymb}
\setlength{\grammarindent}{100pt}
\usepackage{subcaption} % subfigures

%%%%%%%flotte listings
\definecolor{dkgreen}{rgb}{0,0.6,0}
\definecolor{gray}{rgb}{0.5,0.5,0.5}
\definecolor{mauve}{rgb}{0.58,0,0.82}

\newcommand{\cmark}{\ding{51}}%Checkmark

\lstdefinelanguage{scala}{
  morekeywords={abstract,case,catch,class,def,%
    do,else,extends,false,final,finally,%
    for,if,implicit,import,match,mixin,%
    new,null,object,override,package,%
    private,protected,requires,return,sealed,%
    super,this,throw,trait,true,try,%
    type,val,var,while,with,yield},
  otherkeywords={=>,<-,<\%,<:,>:,\#,@},
  sensitive=true,
  morecomment=[l]{//},
  morecomment=[n]{/*}{*/},
  morestring=[b]",
  morestring=[b]',
  morestring=[b]"""
}

\lstdefinelanguage{TLDR}{
  keywords={else,in,for,if,return,try,var,while,let,actor,struct,receive,send,spawn},
  keywords=[2]{int,real,bool,args,char},
  keywords=[3]{->,:=,=,>,<,+,-,*,/,..,<=,>=,\#,^},
  keywords=[4]{me,true,false},
  sensitive=true,
  morecomment=[l]{//},
  morecomment=[n]{/*}{*/},
  morestring=[b]",
  morestring=[b]',
  morestring=[b]"""
}
\lstdefinestyle{TLDR}{
  language=TLDR,
  alsoletter={->,:=,:,..,+,<=,>=,*,^},
  aboveskip=2mm,
  belowskip=2mm,
	commentstyle=\color{gray},
	stringstyle=\color{string},
	keywordstyle=\color{mauve},
	keywordstyle=[2]\color{blue},
	keywordstyle=[3]\color{register},
	keywordstyle=[4]\color{orange},
	literate=%
	  {:}{{\textcolor{register}{:}}}1%
	  {0}{{{\textcolor{orange}{0}}}}1%
	  {1}{{{\textcolor{orange}{1}}}}1%
	  {2}{{{\textcolor{orange}{2}}}}1%
	  {3}{{{\textcolor{orange}{3}}}}1%
	  {4}{{{\textcolor{orange}{4}}}}1%
	  {5}{{{\textcolor{orange}{5}}}}1%
	  {6}{{{\textcolor{orange}{6}}}}1%
	  {7}{{{\textcolor{orange}{7}}}}1%
	  {8}{{{\textcolor{orange}{8}}}}1%
	  {9}{{{\textcolor{orange}{9}}}}1,
	basicstyle=\footnotesize\ttfamily,
	numbers=left,
	numberstyle=\tiny,
	numbersep=5pt,
	breaklines=true,
	showstringspaces=false,
	upquote=true,
	tabsize=4,
}

\lstdefinestyle{scala}{
  language=scala,
  aboveskip=2mm,
  belowskip=2mm,
	commentstyle=\color{comment},
	stringstyle=\color{string},
	keywordstyle=\color{instruction},
	keywordstyle=[2]\color{directive},
	keywordstyle=[3]\color{register},
	basicstyle=\footnotesize\ttfamily,
	numbers=left,
	numberstyle=\tiny,
	numbersep=5pt,
	breaklines=true,
	showstringspaces=false,
	upquote=true,
	tabsize=4,
}

\lstdefinestyle{erlang}{
  language=erlang,
  aboveskip=2mm,
  belowskip=2mm,
	commentstyle=\color{comment},
	stringstyle=\color{string},
	keywordstyle=\color{instruction},
	keywordstyle=[2]\color{directive},
	keywordstyle=[3]\color{register},
	basicstyle=\footnotesize\ttfamily,
	numbers=left,
	numberstyle=\tiny,
	numbersep=5pt,
	breaklines=true,
	showstringspaces=false,
	upquote=true,
	tabsize=4,
}

\lstdefinelanguage{fsharp}%
{morekeywords={let, new, match, with, rec, open, module, namespace, type, of, member, %
and, for, while, true, false, in, do, begin, end, fun, function, return, yield, try, %
mutable, if, then, else, cloud, async, static, use, abstract, interface, inherit, finally },
  otherkeywords={ let!, return!, do!, yield!, use!, var, from, select, where, order, by },
  keywordstyle=\color{bluekeywords},
  sensitive=true,
  basicstyle=\ttfamily,
	breaklines=true,
  xleftmargin=\parindent,
  aboveskip=\bigskipamount,
	tabsize=4,
  morecomment=[l][\color{dkgreen}]{///},
  morecomment=[l][\color{dkgreen}]{//},
  morecomment=[s][\color{dkgreen}]{{(*}{*)}},
  morestring=[b]",
  showstringspaces=false,
  literate={`}{\`}1,
  stringstyle=\color{redstrings},
}

\lstdefinestyle{fsharp}{
  language=fsharp,
  aboveskip=2mm,
  belowskip=2mm,
	commentstyle=\color{comment},
	stringstyle=\color{string},
	keywordstyle=\color{instruction},
	keywordstyle=[2]\color{directive},
	keywordstyle=[3]\color{register},
	basicstyle=\footnotesize\ttfamily,
	numbers=left,
	numberstyle=\tiny,
	numbersep=5pt,
	breaklines=true,
	showstringspaces=false,
	upquote=true,
	tabsize=4,
}

\lstdefinelanguage{llvm}{
	sensitive=true,
	alsoletter={\%},
	% comments.
	%    ; line comment
	comment=[l]{;},
	% strings.
	%    "foo"
	string=[b]{"},
	% instructions.
	%    ref: http://llvm.org/docs/LangRef.html#instruction-reference
	keywords=[1]{
add, addrspacecast, alloca, and, ashr, atomicrmw, bitcast, br, call, cmpxchg,
extractelement, extractvalue, fadd, fcmp, fdiv, fence, fmul, fpext, fptosi,
fptoui, fptrunc, frem, fsub, getelementptr, icmp, indirectbr, insertelement,
insertvalue, inttoptr, invoke, landingpad, load, lshr, mul, or, phi, ptrtoint,
resume, ret, sdiv, select, sext, shl, shufflevector, sitofp, srem, store, sub,
switch, to, trunc, udiv, uitofp, unreachable, urem, va_arg, xor, zext
	},
	% directives.
	%    ref: http://llvm.org/docs/LangRef.html
	keywords=[2]{
acq_rel, acquire, addrspace, alias, align, alignstack, alwaysinline, any,
anyregcc, appending, arcp, arm_aapcs_vfpcc, arm_aapcscc, arm_apcscc, asm,
atomic, attributes, available_externally, blockaddress, builtin, byval, c,
catch, cc, ccc, cleanup, cold, coldcc, comdat, common, constant, datalayout,
declare, default, define, dereferenceable, dllexport, dllimport, eq, exact,
exactmatch, extern_weak, external, externally_initialized, false, fast, fastcc,
filter, gc, ghccc, global, hidden, inalloca, inbounds, initialexec, inlinehint,
inreg, intel_ocl_bicc, inteldialect, internal, jumptable, largest, linkonce,
linkonce_odr, localdynamic, localexec, max, min, minsize, module, monotonic,
msp430_intrcc, musttail, naked, nand, ne, nest, ninf, nnan, noalias, nobuiltin,
nocapture, noduplicate, noduplicates, noimplicitfloat, noinline, nonlazybind,
nonnull, noredzone, noreturn, nounwind, nsw, nsz, null, nuw, oeq, oge, ogt, ole,
olt, one, opaque, optnone, optsize, ord, personality, prefix, preserve_allcc,
preserve_mostcc, private, prologue, protected, ptx_device, ptx_kernel, readnone,
readonly, release, returned, returns_twice, samesize, sanitize_address,
sanitize_memory, sanitize_thread, section, seq_cst, sge, sgt, sideeffect,
signext, singlethread, sle, slt, spir_func, spir_kernel, sret, ssp, sspreq,
sspstrong, tail, target, thread_local, triple, true, type, ueq, uge, ugt, ule,
ult, umax, umin, undef, une, unnamed_addr, uno, unordered, unwind, uselistorder,
uselistorder_bb, uwtable, volatile, weak, weak_odr, webkit_jscc, x,
x86_64_sysvcc, x86_64_win64cc, x86_fastcallcc, x86_stdcallcc, x86_thiscallcc,
x86_vectorcallcc, xchg, zeroext, zeroinitializer
	},
	% types.
	%    ref: http://llvm.org/docs/LangRef.html#type-system
	keywords=[3]{
i1, i2, i3, i4, i5, i6, i7, i8, i9, i10, i11, i12, i13, i14, i15, i16, i17, i18,
i19, i20, i21, i22, i23, i24, i25, i26, i27, i28, i29, i30, i31, i32, i33, i34,
i35, i36, i37, i38, i39, i40, i41, i42, i43, i44, i45, i46, i47, i48, i49, i50,
i51, i52, i53, i54, i55, i56, i57, i58, i59, i60, i61, i62, i63, i64, i80, i512,
void, half, float, double, fp128, x86_fp80, ppc_fp128, x86_mmx, label, metadata
	},
}

\lstdefinestyle{llvm}{
  language=llvm,
  aboveskip=2mm,
  belowskip=2mm,
	commentstyle=\color{comment},
	stringstyle=\color{string},
	keywordstyle=\color{instruction},
	keywordstyle=[2]\color{directive},
	keywordstyle=[3]\color{register},
	basicstyle=\footnotesize\ttfamily,
	numbers=left,
	numberstyle=\tiny,
	numbersep=5pt,
	breaklines=true,
	showstringspaces=false,
	upquote=true,
	tabsize=4,
}

\lstdefinelanguage{nasm}{
	sensitive=true,
	alsoletter={\%},
	% comments.
	%    ; line comment
	comment=[l]{;},
	% strings.
	%    "foo"
	%    'bar'
	string=[b]{"},
	morestring=[b]{'},
	% instructions.
	%    ref: http://www.nasm.us/doc/nasmdocb.html
	keywords=[1]{
AAA, AAD, AAM, AAS, ADC, ADCX, ADD, ADDPD, ADDPS, ADDSD, ADDSS, ADDSUBPD,
ADDSUBPS, ADOX, AESDEC, AESDECLAST, AESENC, AESENCLAST, AESIMC, AESKEYGENASSIST,
AND, ANDN, ANDNPD, ANDNPS, ANDPD, ANDPS, ARPL, BEXTR, BLCFILL, BLCI, BLCIC,
BLCMSK, BLCS, BLENDPD, BLENDPS, BLENDVPD, BLENDVPS, BLSFILL, BLSI, BLSIC,
BLSMSK, BLSR, BNDCL, BNDCN, BNDCU, BNDLDX, BNDMK, BNDMOV, BNDSTX, BOUND, BSF,
BSR, BSWAP, BT, BTC, BTR, BTS, BZHI, CALL, CBW, CDQ, CDQE, CLAC, CLC, CLD,
CLFLUSH, CLFLUSHOPT, CLGI, CLI, CLTS, CMC, CMOVA, CMOVAE, CMOVB, CMOVBE, CMOVC,
CMOVE, CMOVG, CMOVGE, CMOVL, CMOVLE, CMOVNA, CMOVNAE, CMOVNB, CMOVNBE, CMOVNC,
CMOVNE, CMOVNG, CMOVNGE, CMOVNL, CMOVNLE, CMOVNO, CMOVNP, CMOVNS, CMOVNZ, CMOVO,
CMOVP, CMOVPE, CMOVPO, CMOVS, CMOVZ, CMP, CMPEQPD, CMPEQPS, CMPEQSD, CMPEQSS,
CMPLEPD, CMPLEPS, CMPLESD, CMPLESS, CMPLTPD, CMPLTPS, CMPLTSD, CMPLTSS,
CMPNEQPD, CMPNEQPS, CMPNEQSD, CMPNEQSS, CMPNLEPD, CMPNLEPS, CMPNLESD, CMPNLESS,
CMPNLTPD, CMPNLTPS, CMPNLTSD, CMPNLTSS, CMPORDPD, CMPORDPS, CMPORDSD, CMPORDSS,
CMPPD, CMPPS, CMPSB, CMPSD, CMPSQ, CMPSS, CMPSW, CMPUNORDPD, CMPUNORDPS,
CMPUNORDSD, CMPUNORDSS, CMPXCHG, CMPXCHG16B, CMPXCHG486, CMPXCHG8B, COMISD,
COMISS, CPUID, CQO, CRC32, CVTDQ2PD, CVTDQ2PS, CVTPD2DQ, CVTPD2PI, CVTPD2PS,
CVTPI2PD, CVTPI2PS, CVTPS2DQ, CVTPS2PD, CVTPS2PI, CVTSD2SI, CVTSD2SS, CVTSI2SD,
CVTSI2SS, CVTSS2SD, CVTSS2SI, CVTTPD2DQ, CVTTPD2PI, CVTTPS2DQ, CVTTPS2PI,
CVTTSD2SI, CVTTSS2SI, CWD, CWDE, DAA, DAS, DEC, DIV, DIVPD, DIVPS, DIVSD, DIVSS,
DMINT, DPPD, DPPS, EMMS, ENTER, EXTRACTPS, EXTRQ, F2XM1, FABS, FADD, FADDP,
FBLD, FBSTP, FCHS, FCLEX, FCMOVB, FCMOVBE, FCMOVE, FCMOVNB, FCMOVNBE, FCMOVNE,
FCMOVNU, FCMOVU, FCOM, FCOMI, FCOMIP, FCOMP, FCOMPP, FCOS, FDECSTP, FDISI, FDIV,
FDIVP, FDIVR, FDIVRP, FEMMS, FENI, FFREE, FFREEP, FIADD, FICOM, FICOMP, FIDIV,
FIDIVR, FILD, FIMUL, FINCSTP, FINIT, FIST, FISTP, FISTTP, FISUB, FISUBR, FLD,
FLD1, FLDCW, FLDENV, FLDL2E, FLDL2T, FLDLG2, FLDLN2, FLDPI, FLDZ, FMUL, FMULP,
FNCLEX, FNDISI, FNENI, FNINIT, FNOP, FNSAVE, FNSTCW, FNSTENV, FNSTSW, FPATAN,
FPREM, FPREM1, FPTAN, FRNDINT, FRSTOR, FSAVE, FSCALE, FSETPM, FSIN, FSINCOS,
FSQRT, FST, FSTCW, FSTENV, FSTP, FSTSW, FSUB, FSUBP, FSUBR, FSUBRP, FTST, FUCOM,
FUCOMI, FUCOMIP, FUCOMP, FUCOMPP, FWAIT, FXAM, FXCH, FXRSTOR, FXRSTOR64, FXSAVE,
FXSAVE64, FXTRACT, FYL2X, FYL2XP1, GETSEC, HADDPD, HADDPS, HLT, HSUBPD, HSUBPS,
IBTS, ICEBP, IDIV, IMUL, IN, INC, INCBIN, INSB, INSD, INSERTPS, INSERTQ, INSW,
INT, INT01, INT03, INT1, INT3, INTO, INVD, INVEPT, INVLPG, INVLPGA, INVPCID,
INVVPID, IRET, IRETD, IRETQ, IRETW, JA, JAE, JB, JBE, JC, JCXZ, JE, JECXZ, JG,
JGE, JL, JLE, JMP, JMPE, JNA, JNAE, JNB, JNBE, JNC, JNE, JNG, JNGE, JNL, JNLE,
JNO, JNP, JNS, JNZ, JO, JP, JPE, JPO, JRCXZ, JS, JZ, KADDB, KADDD, KADDQ, KADDW,
KANDB, KANDD, KANDNB, KANDND, KANDNQ, KANDNW, KANDQ, KANDW, KMOVB, KMOVD, KMOVQ,
KMOVW, KNOTB, KNOTD, KNOTQ, KNOTW, KORB, KORD, KORQ, KORTESTB, KORTESTD,
KORTESTQ, KORTESTW, KORW, KSHIFTLB, KSHIFTLD, KSHIFTLQ, KSHIFTLW, KSHIFTRB,
KSHIFTRD, KSHIFTRQ, KSHIFTRW, KTESTB, KTESTD, KTESTQ, KTESTW, KUNPCKBW,
KUNPCKDQ, KUNPCKWD, KXNORB, KXNORD, KXNORQ, KXNORW, KXORB, KXORD, KXORQ, KXORW,
LAHF, LAR, LDDQU, LDMXCSR, LDS, LEA, LEAVE, LES, LFENCE, LFS, LGDT, LGS, LIDT,
LLDT, LLWPCB, LMSW, LOADALL, LOADALL286, LODSB, LODSD, LODSQ, LODSW, LOOP,
LOOPE, LOOPNE, LOOPNZ, LOOPZ, LSL, LSS, LTR, LWPINS, LWPVAL, LZCNT, MASKMOVDQU,
MASKMOVQ, MAXPD, MAXPS, MAXSD, MAXSS, MFENCE, MINPD, MINPS, MINSD, MINSS,
MONITOR, MONTMUL, MOV, MOVAPD, MOVAPS, MOVBE, MOVD, MOVDDUP, MOVDQ2Q, MOVDQA,
MOVDQU, MOVHLPS, MOVHPD, MOVHPS, MOVLHPS, MOVLPD, MOVLPS, MOVMSKPD, MOVMSKPS,
MOVNTDQ, MOVNTDQA, MOVNTI, MOVNTPD, MOVNTPS, MOVNTQ, MOVNTSD, MOVNTSS, MOVQ,
MOVQ2DQ, MOVSB, MOVSD, MOVSHDUP, MOVSLDUP, MOVSQ, MOVSS, MOVSW, MOVSX, MOVSXD,
MOVUPD, MOVUPS, MOVZX, MPSADBW, MUL, MULPD, MULPS, MULSD, MULSS, MULX, MWAIT,
NEG, NOP, NOT, OR, ORPD, ORPS, OUT, OUTSB, OUTSD, OUTSW, PABSB, PABSD, PABSW,
PACKSSDW, PACKSSWB, PACKUSDW, PACKUSWB, PADDB, PADDD, PADDQ, PADDSB, PADDSIW,
PADDSW, PADDUSB, PADDUSW, PADDW, PALIGNR, PAND, PANDN, PAUSE, PAVEB, PAVGB,
PAVGUSB, PAVGW, PBLENDVB, PBLENDW, PCLMULHQHQDQ, PCLMULHQLQDQ, PCLMULLQHQDQ,
PCLMULLQLQDQ, PCLMULQDQ, PCMPEQB, PCMPEQD, PCMPEQQ, PCMPEQW, PCMPESTRI,
PCMPESTRM, PCMPGTB, PCMPGTD, PCMPGTQ, PCMPGTW, PCMPISTRI, PCMPISTRM, PDEP,
PDISTIB, PEXT, PEXTRB, PEXTRD, PEXTRQ, PEXTRW, PF2ID, PF2IW, PFACC, PFADD,
PFCMPEQ, PFCMPGE, PFCMPGT, PFMAX, PFMIN, PFMUL, PFNACC, PFPNACC, PFRCP,
PFRCPIT1, PFRCPIT2, PFRCPV, PFRSQIT1, PFRSQRT, PFRSQRTV, PFSUB, PFSUBR, PHADDD,
PHADDSW, PHADDW, PHMINPOSUW, PHSUBD, PHSUBSW, PHSUBW, PI2FD, PI2FW, PINSRB,
PINSRD, PINSRQ, PINSRW, PMACHRIW, PMADDUBSW, PMADDWD, PMAGW, PMAXSB, PMAXSD,
PMAXSW, PMAXUB, PMAXUD, PMAXUW, PMINSB, PMINSD, PMINSW, PMINUB, PMINUD, PMINUW,
PMOVMSKB, PMOVSXBD, PMOVSXBQ, PMOVSXBW, PMOVSXDQ, PMOVSXWD, PMOVSXWQ, PMOVZXBD,
PMOVZXBQ, PMOVZXBW, PMOVZXDQ, PMOVZXWD, PMOVZXWQ, PMULDQ, PMULHRIW, PMULHRSW,
PMULHRWA, PMULHRWC, PMULHUW, PMULHW, PMULLD, PMULLW, PMULUDQ, PMVGEZB, PMVLZB,
PMVNZB, PMVZB, POP, POPA, POPAD, POPAW, POPCNT, POPF, POPFD, POPFQ, POPFW, POR,
PREFETCH, PREFETCHNTA, PREFETCHT0, PREFETCHT1, PREFETCHT2, PREFETCHW,
PREFETCHWT1, PSADBW, PSHUFB, PSHUFD, PSHUFHW, PSHUFLW, PSHUFW, PSIGNB, PSIGND,
PSIGNW, PSLLD, PSLLDQ, PSLLQ, PSLLW, PSRAD, PSRAW, PSRLD, PSRLDQ, PSRLQ, PSRLW,
PSUBB, PSUBD, PSUBQ, PSUBSB, PSUBSIW, PSUBSW, PSUBUSB, PSUBUSW, PSUBW, PSWAPD,
PTEST, PUNPCKHBW, PUNPCKHDQ, PUNPCKHQDQ, PUNPCKHWD, PUNPCKLBW, PUNPCKLDQ,
PUNPCKLQDQ, PUNPCKLWD, PUSH, PUSHA, PUSHAD, PUSHAW, PUSHF, PUSHFD, PUSHFQ,
PUSHFW, PXOR, RCL, RCPPS, RCPSS, RCR, RDFSBASE, RDGSBASE, RDM, RDMSR, RDPMC,
RDRAND, RDSEED, RDSHR, RDTSC, RDTSCP, RET, RETF, RETN, ROL, ROR, RORX, ROUNDPD,
ROUNDPS, ROUNDSD, ROUNDSS, RSDC, RSLDT, RSM, RSQRTPS, RSQRTSS, RSTS, SAHF, SAL,
SALC, SAR, SARX, SBB, SCASB, SCASD, SCASQ, SCASW, SETA, SETAE, SETB, SETBE,
SETC, SETE, SETG, SETGE, SETL, SETLE, SETNA, SETNAE, SETNB, SETNBE, SETNC,
SETNE, SETNG, SETNGE, SETNL, SETNLE, SETNO, SETNP, SETNS, SETNZ, SETO, SETP,
SETPE, SETPO, SETS, SETZ, SFENCE, SGDT, SHA1MSG1, SHA1MSG2, SHA1NEXTE,
SHA1RNDS4, SHA256MSG1, SHA256MSG2, SHA256RNDS2, SHL, SHLD, SHLX, SHR, SHRD,
SHRX, SHUFPD, SHUFPS, SIDT, SKINIT, SLDT, SLWPCB, SMI, SMINT, SMINTOLD, SMSW,
SQRTPD, SQRTPS, SQRTSD, SQRTSS, STAC, STC, STD, STGI, STI, STMXCSR, STOSB,
STOSD, STOSQ, STOSW, STR, SUB, SUBPD, SUBPS, SUBSD, SUBSS, SVDC, SVLDT, SVTS,
SWAPGS, SYSCALL, SYSENTER, SYSEXIT, SYSRET, T1MSKC, TEST, TZCNT, TZMSK, UCOMISD,
UCOMISS, UD0, UD1, UD2, UD2A, UD2B, UMOV, UNPCKHPD, UNPCKHPS, UNPCKLPD,
UNPCKLPS, VADDPD, VADDPS, VADDSD, VADDSS, VADDSUBPD, VADDSUBPS, VAESDEC,
VAESDECLAST, VAESENC, VAESENCLAST, VAESIMC, VAESKEYGENASSIST, VALIGND, VALIGNQ,
VANDNPD, VANDNPS, VANDPD, VANDPS, VBLENDMPD, VBLENDMPS, VBLENDPD, VBLENDPS,
VBLENDVPD, VBLENDVPS, VBROADCASTF128, VBROADCASTF32X2, VBROADCASTF32X4,
VBROADCASTF32X8, VBROADCASTF64X2, VBROADCASTF64X4, VBROADCASTI128,
VBROADCASTI32X2, VBROADCASTI32X4, VBROADCASTI32X8, VBROADCASTI64X2,
VBROADCASTI64X4, VBROADCASTSD, VBROADCASTSS, VCMPEQPD, VCMPEQPS, VCMPEQSD,
VCMPEQSS, VCMPFALSEPD, VCMPFALSEPS, VCMPFALSESD, VCMPFALSESS, VCMPGEPD,
VCMPGEPS, VCMPGESD, VCMPGESS, VCMPGTPD, VCMPGTPS, VCMPGTSD, VCMPGTSS, VCMPLEPD,
VCMPLEPS, VCMPLESD, VCMPLESS, VCMPLTPD, VCMPLTPS, VCMPLTSD, VCMPLTSS, VCMPNEQPD,
VCMPNEQPS, VCMPNEQSD, VCMPNEQSS, VCMPNGEPD, VCMPNGEPS, VCMPNGESD, VCMPNGESS,
VCMPNGTPD, VCMPNGTPS, VCMPNGTSD, VCMPNGTSS, VCMPNLEPD, VCMPNLEPS, VCMPNLESD,
VCMPNLESS, VCMPNLTPD, VCMPNLTPS, VCMPNLTSD, VCMPNLTSS, VCMPORDPD, VCMPORDPS,
VCMPORDSD, VCMPORDSS, VCMPPD, VCMPPS, VCMPSD, VCMPSS, VCMPTRUEPD, VCMPTRUEPS,
VCMPTRUESD, VCMPTRUESS, VCMPUNORDPD, VCMPUNORDPS, VCMPUNORDSD, VCMPUNORDSS,
VCOMISD, VCOMISS, VCOMPRESSPD, VCOMPRESSPS, VCVTDQ2PD, VCVTDQ2PS, VCVTPD2DQ,
VCVTPD2PS, VCVTPD2QQ, VCVTPD2UDQ, VCVTPD2UQQ, VCVTPH2PS, VCVTPS2DQ, VCVTPS2PD,
VCVTPS2PH, VCVTPS2QQ, VCVTPS2UDQ, VCVTPS2UQQ, VCVTQQ2PD, VCVTQQ2PS, VCVTSD2SI,
VCVTSD2SS, VCVTSD2USI, VCVTSI2SD, VCVTSI2SS, VCVTSS2SD, VCVTSS2SI, VCVTSS2USI,
VCVTTPD2DQ, VCVTTPD2QQ, VCVTTPD2UDQ, VCVTTPD2UQQ, VCVTTPS2DQ, VCVTTPS2QQ,
VCVTTPS2UDQ, VCVTTPS2UQQ, VCVTTSD2SI, VCVTTSD2USI, VCVTTSS2SI, VCVTTSS2USI,
VCVTUDQ2PD, VCVTUDQ2PS, VCVTUQQ2PD, VCVTUQQ2PS, VCVTUSI2SD, VCVTUSI2SS,
VDBPSADBW, VDIVPD, VDIVPS, VDIVSD, VDIVSS, VDPPD, VDPPS, VERR, VERW, VEXP2PD,
VEXP2PS, VEXPANDPD, VEXPANDPS, VEXTRACTF128, VEXTRACTF32X4, VEXTRACTF32X8,
VEXTRACTF64X2, VEXTRACTF64X4, VEXTRACTI128, VEXTRACTI32X4, VEXTRACTI32X8,
VEXTRACTI64X2, VEXTRACTI64X4, VEXTRACTPS, VFIXUPIMMPD, VFIXUPIMMPS, VFIXUPIMMSD,
VFIXUPIMMSS, VFMADD123PD, VFMADD123PS, VFMADD123SD, VFMADD123SS, VFMADD132PD,
VFMADD132PS, VFMADD132SD, VFMADD132SS, VFMADD213PD, VFMADD213PS, VFMADD213SD,
VFMADD213SS, VFMADD231PD, VFMADD231PS, VFMADD231SD, VFMADD231SS, VFMADD312PD,
VFMADD312PS, VFMADD312SD, VFMADD312SS, VFMADD321PD, VFMADD321PS, VFMADD321SD,
VFMADD321SS, VFMADDPD, VFMADDPS, VFMADDSD, VFMADDSS, VFMADDSUB123PD,
VFMADDSUB123PS, VFMADDSUB132PD, VFMADDSUB132PS, VFMADDSUB213PD, VFMADDSUB213PS,
VFMADDSUB231PD, VFMADDSUB231PS, VFMADDSUB312PD, VFMADDSUB312PS, VFMADDSUB321PD,
VFMADDSUB321PS, VFMADDSUBPD, VFMADDSUBPS, VFMSUB123PD, VFMSUB123PS, VFMSUB123SD,
VFMSUB123SS, VFMSUB132PD, VFMSUB132PS, VFMSUB132SD, VFMSUB132SS, VFMSUB213PD,
VFMSUB213PS, VFMSUB213SD, VFMSUB213SS, VFMSUB231PD, VFMSUB231PS, VFMSUB231SD,
VFMSUB231SS, VFMSUB312PD, VFMSUB312PS, VFMSUB312SD, VFMSUB312SS, VFMSUB321PD,
VFMSUB321PS, VFMSUB321SD, VFMSUB321SS, VFMSUBADD123PD, VFMSUBADD123PS,
VFMSUBADD132PD, VFMSUBADD132PS, VFMSUBADD213PD, VFMSUBADD213PS, VFMSUBADD231PD,
VFMSUBADD231PS, VFMSUBADD312PD, VFMSUBADD312PS, VFMSUBADD321PD, VFMSUBADD321PS,
VFMSUBADDPD, VFMSUBADDPS, VFMSUBPD, VFMSUBPS, VFMSUBSD, VFMSUBSS, VFNMADD123PD,
VFNMADD123PS, VFNMADD123SD, VFNMADD123SS, VFNMADD132PD, VFNMADD132PS,
VFNMADD132SD, VFNMADD132SS, VFNMADD213PD, VFNMADD213PS, VFNMADD213SD,
VFNMADD213SS, VFNMADD231PD, VFNMADD231PS, VFNMADD231SD, VFNMADD231SS,
VFNMADD312PD, VFNMADD312PS, VFNMADD312SD, VFNMADD312SS, VFNMADD321PD,
VFNMADD321PS, VFNMADD321SD, VFNMADD321SS, VFNMADDPD, VFNMADDPS, VFNMADDSD,
VFNMADDSS, VFNMSUB123PD, VFNMSUB123PS, VFNMSUB123SD, VFNMSUB123SS, VFNMSUB132PD,
VFNMSUB132PS, VFNMSUB132SD, VFNMSUB132SS, VFNMSUB213PD, VFNMSUB213PS,
VFNMSUB213SD, VFNMSUB213SS, VFNMSUB231PD, VFNMSUB231PS, VFNMSUB231SD,
VFNMSUB231SS, VFNMSUB312PD, VFNMSUB312PS, VFNMSUB312SD, VFNMSUB312SS,
VFNMSUB321PD, VFNMSUB321PS, VFNMSUB321SD, VFNMSUB321SS, VFNMSUBPD, VFNMSUBPS,
VFNMSUBSD, VFNMSUBSS, VFPCLASSPD, VFPCLASSPS, VFPCLASSSD, VFPCLASSSS, VFRCZPD,
VFRCZPS, VFRCZSD, VFRCZSS, VGATHERDPD, VGATHERDPS, VGATHERPF0DPD, VGATHERPF0DPS,
VGATHERPF0QPD, VGATHERPF0QPS, VGATHERPF1DPD, VGATHERPF1DPS, VGATHERPF1QPD,
VGATHERPF1QPS, VGATHERQPD, VGATHERQPS, VGETEXPPD, VGETEXPPS, VGETEXPSD,
VGETEXPSS, VGETMANTPD, VGETMANTPS, VGETMANTSD, VGETMANTSS, VHADDPD, VHADDPS,
VHSUBPD, VHSUBPS, VINSERTF128, VINSERTF32X4, VINSERTF32X8, VINSERTF64X2,
VINSERTF64X4, VINSERTI128, VINSERTI32X4, VINSERTI32X8, VINSERTI64X2,
VINSERTI64X4, VINSERTPS, VLDDQU, VLDMXCSR, VLDQQU, VMASKMOVDQU, VMASKMOVPD,
VMASKMOVPS, VMAXPD, VMAXPS, VMAXSD, VMAXSS, VMCALL, VMCLEAR, VMFUNC, VMINPD,
VMINPS, VMINSD, VMINSS, VMLAUNCH, VMLOAD, VMMCALL, VMOVAPD, VMOVAPS, VMOVD,
VMOVDDUP, VMOVDQA, VMOVDQA32, VMOVDQA64, VMOVDQU, VMOVDQU16, VMOVDQU32,
VMOVDQU64, VMOVDQU8, VMOVHLPS, VMOVHPD, VMOVHPS, VMOVLHPS, VMOVLPD, VMOVLPS,
VMOVMSKPD, VMOVMSKPS, VMOVNTDQ, VMOVNTDQA, VMOVNTPD, VMOVNTPS, VMOVNTQQ, VMOVQ,
VMOVQQA, VMOVQQU, VMOVSD, VMOVSHDUP, VMOVSLDUP, VMOVSS, VMOVUPD, VMOVUPS,
VMPSADBW, VMPTRLD, VMPTRST, VMREAD, VMRESUME, VMRUN, VMSAVE, VMULPD, VMULPS,
VMULSD, VMULSS, VMWRITE, VMXOFF, VMXON, VORPD, VORPS, VPABSB, VPABSD, VPABSQ,
VPABSW, VPACKSSDW, VPACKSSWB, VPACKUSDW, VPACKUSWB, VPADDB, VPADDD, VPADDQ,
VPADDSB, VPADDSW, VPADDUSB, VPADDUSW, VPADDW, VPALIGNR, VPAND, VPANDD, VPANDN,
VPANDND, VPANDNQ, VPANDQ, VPAVGB, VPAVGW, VPBLENDD, VPBLENDMB, VPBLENDMD,
VPBLENDMQ, VPBLENDMW, VPBLENDVB, VPBLENDW, VPBROADCASTB, VPBROADCASTD,
VPBROADCASTMB2Q, VPBROADCASTMW2D, VPBROADCASTQ, VPBROADCASTW, VPCLMULHQHQDQ,
VPCLMULHQLQDQ, VPCLMULLQHQDQ, VPCLMULLQLQDQ, VPCLMULQDQ, VPCMOV, VPCMPB, VPCMPD,
VPCMPEQB, VPCMPEQD, VPCMPEQQ, VPCMPEQW, VPCMPESTRI, VPCMPESTRM, VPCMPGTB,
VPCMPGTD, VPCMPGTQ, VPCMPGTW, VPCMPISTRI, VPCMPISTRM, VPCMPQ, VPCMPUB, VPCMPUD,
VPCMPUQ, VPCMPUW, VPCMPW, VPCOMB, VPCOMD, VPCOMPRESSD, VPCOMPRESSQ, VPCOMQ,
VPCOMUB, VPCOMUD, VPCOMUQ, VPCOMUW, VPCOMW, VPCONFLICTD, VPCONFLICTQ,
VPERM2F128, VPERM2I128, VPERMB, VPERMD, VPERMI2B, VPERMI2D, VPERMI2PD,
VPERMI2PS, VPERMI2Q, VPERMI2W, VPERMILPD, VPERMILPS, VPERMPD, VPERMPS, VPERMQ,
VPERMT2B, VPERMT2D, VPERMT2PD, VPERMT2PS, VPERMT2Q, VPERMT2W, VPERMW, VPEXPANDD,
VPEXPANDQ, VPEXTRB, VPEXTRD, VPEXTRQ, VPEXTRW, VPGATHERDD, VPGATHERDQ,
VPGATHERQD, VPGATHERQQ, VPHADDBD, VPHADDBQ, VPHADDBW, VPHADDD, VPHADDDQ,
VPHADDSW, VPHADDUBD, VPHADDUBQ, VPHADDUBW, VPHADDUDQ, VPHADDUWD, VPHADDUWQ,
VPHADDW, VPHADDWD, VPHADDWQ, VPHMINPOSUW, VPHSUBBW, VPHSUBD, VPHSUBDQ, VPHSUBSW,
VPHSUBW, VPHSUBWD, VPINSRB, VPINSRD, VPINSRQ, VPINSRW, VPLZCNTD, VPLZCNTQ,
VPMACSDD, VPMACSDQH, VPMACSDQL, VPMACSSDD, VPMACSSDQH, VPMACSSDQL, VPMACSSWD,
VPMACSSWW, VPMACSWD, VPMACSWW, VPMADCSSWD, VPMADCSWD, VPMADD52HUQ, VPMADD52LUQ,
VPMADDUBSW, VPMADDWD, VPMASKMOVD, VPMASKMOVQ, VPMAXSB, VPMAXSD, VPMAXSQ,
VPMAXSW, VPMAXUB, VPMAXUD, VPMAXUQ, VPMAXUW, VPMINSB, VPMINSD, VPMINSQ, VPMINSW,
VPMINUB, VPMINUD, VPMINUQ, VPMINUW, VPMOVB2M, VPMOVD2M, VPMOVDB, VPMOVDW,
VPMOVM2B, VPMOVM2D, VPMOVM2Q, VPMOVM2W, VPMOVMSKB, VPMOVQ2M, VPMOVQB, VPMOVQD,
VPMOVQW, VPMOVSDB, VPMOVSDW, VPMOVSQB, VPMOVSQD, VPMOVSQW, VPMOVSWB, VPMOVSXBD,
VPMOVSXBQ, VPMOVSXBW, VPMOVSXDQ, VPMOVSXWD, VPMOVSXWQ, VPMOVUSDB, VPMOVUSDW,
VPMOVUSQB, VPMOVUSQD, VPMOVUSQW, VPMOVUSWB, VPMOVW2M, VPMOVWB, VPMOVZXBD,
VPMOVZXBQ, VPMOVZXBW, VPMOVZXDQ, VPMOVZXWD, VPMOVZXWQ, VPMULDQ, VPMULHRSW,
VPMULHUW, VPMULHW, VPMULLD, VPMULLQ, VPMULLW, VPMULTISHIFTQB, VPMULUDQ, VPOR,
VPORD, VPORQ, VPPERM, VPROLD, VPROLQ, VPROLVD, VPROLVQ, VPRORD, VPRORQ, VPRORVD,
VPRORVQ, VPROTB, VPROTD, VPROTQ, VPROTW, VPSADBW, VPSCATTERDD, VPSCATTERDQ,
VPSCATTERQD, VPSCATTERQQ, VPSHAB, VPSHAD, VPSHAQ, VPSHAW, VPSHLB, VPSHLD,
VPSHLQ, VPSHLW, VPSHUFB, VPSHUFD, VPSHUFHW, VPSHUFLW, VPSIGNB, VPSIGND, VPSIGNW,
VPSLLD, VPSLLDQ, VPSLLQ, VPSLLVD, VPSLLVQ, VPSLLVW, VPSLLW, VPSRAD, VPSRAQ,
VPSRAVD, VPSRAVQ, VPSRAVW, VPSRAW, VPSRLD, VPSRLDQ, VPSRLQ, VPSRLVD, VPSRLVQ,
VPSRLVW, VPSRLW, VPSUBB, VPSUBD, VPSUBQ, VPSUBSB, VPSUBSW, VPSUBUSB, VPSUBUSW,
VPSUBW, VPTERNLOGD, VPTERNLOGQ, VPTEST, VPTESTMB, VPTESTMD, VPTESTMQ, VPTESTMW,
VPTESTNMB, VPTESTNMD, VPTESTNMQ, VPTESTNMW, VPUNPCKHBW, VPUNPCKHDQ, VPUNPCKHQDQ,
VPUNPCKHWD, VPUNPCKLBW, VPUNPCKLDQ, VPUNPCKLQDQ, VPUNPCKLWD, VPXOR, VPXORD,
VPXORQ, VRANGEPD, VRANGEPS, VRANGESD, VRANGESS, VRCP14PD, VRCP14PS, VRCP14SD,
VRCP14SS, VRCP28PD, VRCP28PS, VRCP28SD, VRCP28SS, VRCPPS, VRCPSS, VREDUCEPD,
VREDUCEPS, VREDUCESD, VREDUCESS, VRNDSCALEPD, VRNDSCALEPS, VRNDSCALESD,
VRNDSCALESS, VROUNDPD, VROUNDPS, VROUNDSD, VROUNDSS, VRSQRT14PD, VRSQRT14PS,
VRSQRT14SD, VRSQRT14SS, VRSQRT28PD, VRSQRT28PS, VRSQRT28SD, VRSQRT28SS,
VRSQRTPS, VRSQRTSS, VSCALEFPD, VSCALEFPS, VSCALEFSD, VSCALEFSS, VSCATTERDPD,
VSCATTERDPS, VSCATTERPF0DPD, VSCATTERPF0DPS, VSCATTERPF0QPD, VSCATTERPF0QPS,
VSCATTERPF1DPD, VSCATTERPF1DPS, VSCATTERPF1QPD, VSCATTERPF1QPS, VSCATTERQPD,
VSCATTERQPS, VSHUFF32X4, VSHUFF64X2, VSHUFI32X4, VSHUFI64X2, VSHUFPD, VSHUFPS,
VSQRTPD, VSQRTPS, VSQRTSD, VSQRTSS, VSTMXCSR, VSUBPD, VSUBPS, VSUBSD, VSUBSS,
VTESTPD, VTESTPS, VUCOMISD, VUCOMISS, VUNPCKHPD, VUNPCKHPS, VUNPCKLPD,
VUNPCKLPS, VXORPD, VXORPS, VZEROALL, VZEROUPPER, WBINVD, WRFSBASE, WRGSBASE,
WRMSR, WRSHR, XABORT, XADD, XBEGIN, XBTS, XCHG, XCRYPTCBC, XCRYPTCFB, XCRYPTCTR,
XCRYPTECB, XCRYPTOFB, XEND, XGETBV, XLAT, XLATB, XOR, XORPD, XORPS, XRSTOR,
XRSTOR64, XRSTORS, XRSTORS64, XSAVE, XSAVE64, XSAVEC, XSAVEC64, XSAVEOPT,
XSAVEOPT64, XSAVES, XSAVES64, XSETBV, XSHA1, XSHA256, XSTORE, XTEST,
aaa, aad, aam, aas, adc, adcx, add, addpd, addps, addsd, addss, addsubpd,
addsubps, adox, aesdec, aesdeclast, aesenc, aesenclast, aesimc, aeskeygenassist,
and, andn, andnpd, andnps, andpd, andps, arpl, bextr, blcfill, blci, blcic,
blcmsk, blcs, blendpd, blendps, blendvpd, blendvps, blsfill, blsi, blsic,
blsmsk, blsr, bndcl, bndcn, bndcu, bndldx, bndmk, bndmov, bndstx, bound, bsf,
bsr, bswap, bt, btc, btr, bts, bzhi, call, callq, cbw, cdq, cdqe, clac, clc, cld,
clflush, clflushopt, clgi, cli, clts, cmc, cmova, cmovae, cmovb, cmovbe, cmovc,
cmove, cmovg, cmovge, cmovl, cmovle, cmovna, cmovnae, cmovnb, cmovnbe, cmovnc,
cmovne, cmovng, cmovnge, cmovnl, cmovnle, cmovno, cmovnp, cmovns, cmovnz, cmovo,
cmovp, cmovpe, cmovpo, cmovs, cmovz, cmp, cmpeqpd, cmpeqps, cmpeqsd, cmpeqss,
cmplepd, cmpleps, cmplesd, cmpless, cmpltpd, cmpltps, cmpltsd, cmpltss,
cmpneqpd, cmpneqps, cmpneqsd, cmpneqss, cmpnlepd, cmpnleps, cmpnlesd, cmpnless,
cmpnltpd, cmpnltps, cmpnltsd, cmpnltss, cmpordpd, cmpordps, cmpordsd, cmpordss,
cmppd, cmpps, cmpsb, cmpsd, cmpsq, cmpss, cmpsw, cmpunordpd, cmpunordps,
cmpunordsd, cmpunordss, cmpxchg, cmpxchg16b, cmpxchg486, cmpxchg8b, comisd,
comiss, cpuid, cqo, crc32, cvtdq2pd, cvtdq2ps, cvtpd2dq, cvtpd2pi, cvtpd2ps,
cvtpi2pd, cvtpi2ps, cvtps2dq, cvtps2pd, cvtps2pi, cvtsd2si, cvtsd2ss, cvtsi2sd,
cvtsi2ss, cvtss2sd, cvtss2si, cvttpd2dq, cvttpd2pi, cvttps2dq, cvttps2pi,
cvttsd2si, cvttss2si, cwd, cwde, daa, das, dec, div, divpd, divps, divsd, divss,
dmint, dppd, dpps, emms, enter, extractps, extrq, f2xm1, fabs, fadd, faddp,
fbld, fbstp, fchs, fclex, fcmovb, fcmovbe, fcmove, fcmovnb, fcmovnbe, fcmovne,
fcmovnu, fcmovu, fcom, fcomi, fcomip, fcomp, fcompp, fcos, fdecstp, fdisi, fdiv,
fdivp, fdivr, fdivrp, femms, feni, ffree, ffreep, fiadd, ficom, ficomp, fidiv,
fidivr, fild, fimul, fincstp, finit, fist, fistp, fisttp, fisub, fisubr, fld,
fld1, fldcw, fldenv, fldl2e, fldl2t, fldlg2, fldln2, fldpi, fldz, fmul, fmulp,
fnclex, fndisi, fneni, fninit, fnop, fnsave, fnstcw, fnstenv, fnstsw, fpatan,
fprem, fprem1, fptan, frndint, frstor, fsave, fscale, fsetpm, fsin, fsincos,
fsqrt, fst, fstcw, fstenv, fstp, fstsw, fsub, fsubp, fsubr, fsubrp, ftst, fucom,
fucomi, fucomip, fucomp, fucompp, fwait, fxam, fxch, fxrstor, fxrstor64, fxsave,
fxsave64, fxtract, fyl2x, fyl2xp1, getsec, haddpd, haddps, hlt, hsubpd, hsubps,
ibts, icebp, idiv, imul, in, inc, incbin, insb, insd, insertps, insertq, insw,
int, int01, int03, int1, int3, into, invd, invept, invlpg, invlpga, invpcid,
invvpid, iret, iretd, iretq, iretw, ja, jae, jb, jbe, jc, jcxz, je, jecxz, jg,
jge, jl, jle, jmp, jmpe, jna, jnae, jnb, jnbe, jnc, jne, jng, jnge, jnl, jnle,
jno, jnp, jns, jnz, jo, jp, jpe, jpo, jrcxz, js, jz, kaddb, kaddd, kaddq, kaddw,
kandb, kandd, kandnb, kandnd, kandnq, kandnw, kandq, kandw, kmovb, kmovd, kmovq,
kmovw, knotb, knotd, knotq, knotw, korb, kord, korq, kortestb, kortestd,
kortestq, kortestw, korw, kshiftlb, kshiftld, kshiftlq, kshiftlw, kshiftrb,
kshiftrd, kshiftrq, kshiftrw, ktestb, ktestd, ktestq, ktestw, kunpckbw,
kunpckdq, kunpckwd, kxnorb, kxnord, kxnorq, kxnorw, kxorb, kxord, kxorq, kxorw,
lahf, lar, lddqu, ldmxcsr, lds, lea, leaq, leave, les, lfence, lfs, lgdt, lgs, lidt,
lldt, llwpcb, lmsw, loadall, loadall286, lodsb, lodsd, lodsq, lodsw, loop,
loope, loopne, loopnz, loopz, lsl, lss, ltr, lwpins, lwpval, lzcnt, maskmovdqu,
maskmovq, maxpd, maxps, maxsd, maxss, mfence, minpd, minps, minsd, minss,
monitor, montmul, mov, movapd, movaps, movbe, movd, movddup, movdq2q, movdqa,
movdqu, movhlps, movhpd, movhps, movlhps, movlpd, movlps, movmskpd, movmskps,
movntdq, movntdqa, movnti, movntpd, movntps, movntq, movntsd, movntss, movq,
movq2dq, movsb, movsd, movshdup, movsldup, movsq, movss, movsw, movsx, movsxd,
movupd, movl, movups, movzx, mpsadbw, mul, mulpd, mulps, mulsd, mulss, mulx, mwait,
neg, nop, not, or, orpd, orps, out, outsb, outsd, outsw, pabsb, pabsd, pabsw,
packssdw, packsswb, packusdw, packuswb, paddb, paddd, paddq, paddsb, paddsiw,
paddsw, paddusb, paddusw, paddw, palignr, pand, pandn, pause, paveb, pavgb,
pavgusb, pavgw, pblendvb, pblendw, pclmulhqhqdq, pclmulhqlqdq, pclmullqhqdq,
pclmullqlqdq, pclmulqdq, pcmpeqb, pcmpeqd, pcmpeqq, pcmpeqw, pcmpestri,
pcmpestrm, pcmpgtb, pcmpgtd, pcmpgtq, pcmpgtw, pcmpistri, pcmpistrm, pdep,
pdistib, pext, pextrb, pextrd, pextrq, pextrw, pf2id, pf2iw, pfacc, pfadd,
pfcmpeq, pfcmpge, pfcmpgt, pfmax, pfmin, pfmul, pfnacc, pfpnacc, pfrcp,
pfrcpit1, pfrcpit2, pfrcpv, pfrsqit1, pfrsqrt, pfrsqrtv, pfsub, pfsubr, phaddd,
phaddsw, phaddw, phminposuw, phsubd, phsubsw, phsubw, pi2fd, pi2fw, pinsrb,
pinsrd, pinsrq, pinsrw, pmachriw, pmaddubsw, pmaddwd, pmagw, pmaxsb, pmaxsd,
pmaxsw, pmaxub, pmaxud, pmaxuw, pminsb, pminsd, pminsw, pminub, pminud, pminuw,
pmovmskb, pmovsxbd, pmovsxbq, pmovsxbw, pmovsxdq, pmovsxwd, pmovsxwq, pmovzxbd,
pmovzxbq, pmovzxbw, pmovzxdq, pmovzxwd, pmovzxwq, pmuldq, pmulhriw, pmulhrsw,
pmulhrwa, pmulhrwc, pmulhuw, pmulhw, pmulld, pmullw, pmuludq, pmvgezb, pmvlzb,
pmvnzb, pmvzb, pop, popa, popad, popaw, popcnt, popf, popfd, popfq, popfw, popq, por,
prefetch, prefetchnta, prefetcht0, prefetcht1, prefetcht2, prefetchw,
prefetchwt1, psadbw, pshufb, pshufd, pshufhw, pshuflw, pshufw, psignb, psignd,
psignw, pslld, pslldq, psllq, psllw, psrad, psraw, psrld, psrldq, psrlq, psrlw,
psubb, psubd, psubq, psubsb, psubsiw, psubsw, psubusb, psubusw, psubw, pswapd,
ptest, punpckhbw, punpckhdq, punpckhqdq, punpckhwd, punpcklbw, punpckldq,
punpcklqdq, punpcklwd, push, pusha, pushad, pushaw, pushf, pushfd, pushfq,
pushfw, pushq, pxor, rcl, rcpps, rcpss, rcr, rdfsbase, rdgsbase, rdm, rdmsr, rdpmc,
rdrand, rdseed, rdshr, rdtsc, rdtscp, ret, retf, retn, retq, rol, ror, rorx, roundpd,
roundps, roundsd, roundss, rsdc, rsldt, rsm, rsqrtps, rsqrtss, rsts, sahf, sal,
salc, sar, sarx, sbb, scasb, scasd, scasq, scasw, seta, setae, setb, setbe,
setc, sete, setg, setge, setl, setle, setna, setnae, setnb, setnbe, setnc,
setne, setng, setnge, setnl, setnle, setno, setnp, setns, setnz, seto, setp,
setpe, setpo, sets, setz, sfence, sgdt, sha1msg1, sha1msg2, sha1nexte,
sha1rnds4, sha256msg1, sha256msg2, sha256rnds2, shl, shld, shlx, shr, shrd,
shrx, shufpd, shufps, sidt, skinit, sldt, slwpcb, smi, smint, smintold, smsw,
sqrtpd, sqrtps, sqrtsd, sqrtss, stac, stc, std, stgi, sti, stmxcsr, stosb,
stosd, stosq, stosw, str, sub, subpd, subps, subsd, subss, svdc, svldt, svts,
swapgs, syscall, sysenter, sysexit, sysret, t1mskc, test, tzcnt, tzmsk, ucomisd,
ucomiss, ud0, ud1, ud2, ud2a, ud2b, umov, unpckhpd, unpckhps, unpcklpd,
unpcklps, vaddpd, vaddps, vaddsd, vaddss, vaddsubpd, vaddsubps, vaesdec,
vaesdeclast, vaesenc, vaesenclast, vaesimc, vaeskeygenassist, valignd, valignq,
vandnpd, vandnps, vandpd, vandps, vblendmpd, vblendmps, vblendpd, vblendps,
vblendvpd, vblendvps, vbroadcastf128, vbroadcastf32x2, vbroadcastf32x4,
vbroadcastf32x8, vbroadcastf64x2, vbroadcastf64x4, vbroadcasti128,
vbroadcasti32x2, vbroadcasti32x4, vbroadcasti32x8, vbroadcasti64x2,
vbroadcasti64x4, vbroadcastsd, vbroadcastss, vcmpeqpd, vcmpeqps, vcmpeqsd,
vcmpeqss, vcmpfalsepd, vcmpfalseps, vcmpfalsesd, vcmpfalsess, vcmpgepd,
vcmpgeps, vcmpgesd, vcmpgess, vcmpgtpd, vcmpgtps, vcmpgtsd, vcmpgtss, vcmplepd,
vcmpleps, vcmplesd, vcmpless, vcmpltpd, vcmpltps, vcmpltsd, vcmpltss, vcmpneqpd,
vcmpneqps, vcmpneqsd, vcmpneqss, vcmpngepd, vcmpngeps, vcmpngesd, vcmpngess,
vcmpngtpd, vcmpngtps, vcmpngtsd, vcmpngtss, vcmpnlepd, vcmpnleps, vcmpnlesd,
vcmpnless, vcmpnltpd, vcmpnltps, vcmpnltsd, vcmpnltss, vcmpordpd, vcmpordps,
vcmpordsd, vcmpordss, vcmppd, vcmpps, vcmpsd, vcmpss, vcmptruepd, vcmptrueps,
vcmptruesd, vcmptruess, vcmpunordpd, vcmpunordps, vcmpunordsd, vcmpunordss,
vcomisd, vcomiss, vcompresspd, vcompressps, vcvtdq2pd, vcvtdq2ps, vcvtpd2dq,
vcvtpd2ps, vcvtpd2qq, vcvtpd2udq, vcvtpd2uqq, vcvtph2ps, vcvtps2dq, vcvtps2pd,
vcvtps2ph, vcvtps2qq, vcvtps2udq, vcvtps2uqq, vcvtqq2pd, vcvtqq2ps, vcvtsd2si,
vcvtsd2ss, vcvtsd2usi, vcvtsi2sd, vcvtsi2ss, vcvtss2sd, vcvtss2si, vcvtss2usi,
vcvttpd2dq, vcvttpd2qq, vcvttpd2udq, vcvttpd2uqq, vcvttps2dq, vcvttps2qq,
vcvttps2udq, vcvttps2uqq, vcvttsd2si, vcvttsd2usi, vcvttss2si, vcvttss2usi,
vcvtudq2pd, vcvtudq2ps, vcvtuqq2pd, vcvtuqq2ps, vcvtusi2sd, vcvtusi2ss,
vdbpsadbw, vdivpd, vdivps, vdivsd, vdivss, vdppd, vdpps, verr, verw, vexp2pd,
vexp2ps, vexpandpd, vexpandps, vextractf128, vextractf32x4, vextractf32x8,
vextractf64x2, vextractf64x4, vextracti128, vextracti32x4, vextracti32x8,
vextracti64x2, vextracti64x4, vextractps, vfixupimmpd, vfixupimmps, vfixupimmsd,
vfixupimmss, vfmadd123pd, vfmadd123ps, vfmadd123sd, vfmadd123ss, vfmadd132pd,
vfmadd132ps, vfmadd132sd, vfmadd132ss, vfmadd213pd, vfmadd213ps, vfmadd213sd,
vfmadd213ss, vfmadd231pd, vfmadd231ps, vfmadd231sd, vfmadd231ss, vfmadd312pd,
vfmadd312ps, vfmadd312sd, vfmadd312ss, vfmadd321pd, vfmadd321ps, vfmadd321sd,
vfmadd321ss, vfmaddpd, vfmaddps, vfmaddsd, vfmaddss, vfmaddsub123pd,
vfmaddsub123ps, vfmaddsub132pd, vfmaddsub132ps, vfmaddsub213pd, vfmaddsub213ps,
vfmaddsub231pd, vfmaddsub231ps, vfmaddsub312pd, vfmaddsub312ps, vfmaddsub321pd,
vfmaddsub321ps, vfmaddsubpd, vfmaddsubps, vfmsub123pd, vfmsub123ps, vfmsub123sd,
vfmsub123ss, vfmsub132pd, vfmsub132ps, vfmsub132sd, vfmsub132ss, vfmsub213pd,
vfmsub213ps, vfmsub213sd, vfmsub213ss, vfmsub231pd, vfmsub231ps, vfmsub231sd,
vfmsub231ss, vfmsub312pd, vfmsub312ps, vfmsub312sd, vfmsub312ss, vfmsub321pd,
vfmsub321ps, vfmsub321sd, vfmsub321ss, vfmsubadd123pd, vfmsubadd123ps,
vfmsubadd132pd, vfmsubadd132ps, vfmsubadd213pd, vfmsubadd213ps, vfmsubadd231pd,
vfmsubadd231ps, vfmsubadd312pd, vfmsubadd312ps, vfmsubadd321pd, vfmsubadd321ps,
vfmsubaddpd, vfmsubaddps, vfmsubpd, vfmsubps, vfmsubsd, vfmsubss, vfnmadd123pd,
vfnmadd123ps, vfnmadd123sd, vfnmadd123ss, vfnmadd132pd, vfnmadd132ps,
vfnmadd132sd, vfnmadd132ss, vfnmadd213pd, vfnmadd213ps, vfnmadd213sd,
vfnmadd213ss, vfnmadd231pd, vfnmadd231ps, vfnmadd231sd, vfnmadd231ss,
vfnmadd312pd, vfnmadd312ps, vfnmadd312sd, vfnmadd312ss, vfnmadd321pd,
vfnmadd321ps, vfnmadd321sd, vfnmadd321ss, vfnmaddpd, vfnmaddps, vfnmaddsd,
vfnmaddss, vfnmsub123pd, vfnmsub123ps, vfnmsub123sd, vfnmsub123ss, vfnmsub132pd,
vfnmsub132ps, vfnmsub132sd, vfnmsub132ss, vfnmsub213pd, vfnmsub213ps,
vfnmsub213sd, vfnmsub213ss, vfnmsub231pd, vfnmsub231ps, vfnmsub231sd,
vfnmsub231ss, vfnmsub312pd, vfnmsub312ps, vfnmsub312sd, vfnmsub312ss,
vfnmsub321pd, vfnmsub321ps, vfnmsub321sd, vfnmsub321ss, vfnmsubpd, vfnmsubps,
vfnmsubsd, vfnmsubss, vfpclasspd, vfpclassps, vfpclasssd, vfpclassss, vfrczpd,
vfrczps, vfrczsd, vfrczss, vgatherdpd, vgatherdps, vgatherpf0dpd, vgatherpf0dps,
vgatherpf0qpd, vgatherpf0qps, vgatherpf1dpd, vgatherpf1dps, vgatherpf1qpd,
vgatherpf1qps, vgatherqpd, vgatherqps, vgetexppd, vgetexpps, vgetexpsd,
vgetexpss, vgetmantpd, vgetmantps, vgetmantsd, vgetmantss, vhaddpd, vhaddps,
vhsubpd, vhsubps, vinsertf128, vinsertf32x4, vinsertf32x8, vinsertf64x2,
vinsertf64x4, vinserti128, vinserti32x4, vinserti32x8, vinserti64x2,
vinserti64x4, vinsertps, vlddqu, vldmxcsr, vldqqu, vmaskmovdqu, vmaskmovpd,
vmaskmovps, vmaxpd, vmaxps, vmaxsd, vmaxss, vmcall, vmclear, vmfunc, vminpd,
vminps, vminsd, vminss, vmlaunch, vmload, vmmcall, vmovapd, vmovaps, vmovd,
vmovddup, vmovdqa, vmovdqa32, vmovdqa64, vmovdqu, vmovdqu16, vmovdqu32,
vmovdqu64, vmovdqu8, vmovhlps, vmovhpd, vmovhps, vmovlhps, vmovlpd, vmovlps,
vmovmskpd, vmovmskps, vmovntdq, vmovntdqa, vmovntpd, vmovntps, vmovntqq, vmovq,
vmovqqa, vmovqqu, vmovsd, vmovshdup, vmovsldup, vmovss, vmovupd, vmovups,
vmpsadbw, vmptrld, vmptrst, vmread, vmresume, vmrun, vmsave, vmulpd, vmulps,
vmulsd, vmulss, vmwrite, vmxoff, vmxon, vorpd, vorps, vpabsb, vpabsd, vpabsq,
vpabsw, vpackssdw, vpacksswb, vpackusdw, vpackuswb, vpaddb, vpaddd, vpaddq,
vpaddsb, vpaddsw, vpaddusb, vpaddusw, vpaddw, vpalignr, vpand, vpandd, vpandn,
vpandnd, vpandnq, vpandq, vpavgb, vpavgw, vpblendd, vpblendmb, vpblendmd,
vpblendmq, vpblendmw, vpblendvb, vpblendw, vpbroadcastb, vpbroadcastd,
vpbroadcastmb2q, vpbroadcastmw2d, vpbroadcastq, vpbroadcastw, vpclmulhqhqdq,
vpclmulhqlqdq, vpclmullqhqdq, vpclmullqlqdq, vpclmulqdq, vpcmov, vpcmpb, vpcmpd,
vpcmpeqb, vpcmpeqd, vpcmpeqq, vpcmpeqw, vpcmpestri, vpcmpestrm, vpcmpgtb,
vpcmpgtd, vpcmpgtq, vpcmpgtw, vpcmpistri, vpcmpistrm, vpcmpq, vpcmpub, vpcmpud,
vpcmpuq, vpcmpuw, vpcmpw, vpcomb, vpcomd, vpcompressd, vpcompressq, vpcomq,
vpcomub, vpcomud, vpcomuq, vpcomuw, vpcomw, vpconflictd, vpconflictq,
vperm2f128, vperm2i128, vpermb, vpermd, vpermi2b, vpermi2d, vpermi2pd,
vpermi2ps, vpermi2q, vpermi2w, vpermilpd, vpermilps, vpermpd, vpermps, vpermq,
vpermt2b, vpermt2d, vpermt2pd, vpermt2ps, vpermt2q, vpermt2w, vpermw, vpexpandd,
vpexpandq, vpextrb, vpextrd, vpextrq, vpextrw, vpgatherdd, vpgatherdq,
vpgatherqd, vpgatherqq, vphaddbd, vphaddbq, vphaddbw, vphaddd, vphadddq,
vphaddsw, vphaddubd, vphaddubq, vphaddubw, vphaddudq, vphadduwd, vphadduwq,
vphaddw, vphaddwd, vphaddwq, vphminposuw, vphsubbw, vphsubd, vphsubdq, vphsubsw,
vphsubw, vphsubwd, vpinsrb, vpinsrd, vpinsrq, vpinsrw, vplzcntd, vplzcntq,
vpmacsdd, vpmacsdqh, vpmacsdql, vpmacssdd, vpmacssdqh, vpmacssdql, vpmacsswd,
vpmacssww, vpmacswd, vpmacsww, vpmadcsswd, vpmadcswd, vpmadd52huq, vpmadd52luq,
vpmaddubsw, vpmaddwd, vpmaskmovd, vpmaskmovq, vpmaxsb, vpmaxsd, vpmaxsq,
vpmaxsw, vpmaxub, vpmaxud, vpmaxuq, vpmaxuw, vpminsb, vpminsd, vpminsq, vpminsw,
vpminub, vpminud, vpminuq, vpminuw, vpmovb2m, vpmovd2m, vpmovdb, vpmovdw,
vpmovm2b, vpmovm2d, vpmovm2q, vpmovm2w, vpmovmskb, vpmovq2m, vpmovqb, vpmovqd,
vpmovqw, vpmovsdb, vpmovsdw, vpmovsqb, vpmovsqd, vpmovsqw, vpmovswb, vpmovsxbd,
vpmovsxbq, vpmovsxbw, vpmovsxdq, vpmovsxwd, vpmovsxwq, vpmovusdb, vpmovusdw,
vpmovusqb, vpmovusqd, vpmovusqw, vpmovuswb, vpmovw2m, vpmovwb, vpmovzxbd,
vpmovzxbq, vpmovzxbw, vpmovzxdq, vpmovzxwd, vpmovzxwq, vpmuldq, vpmulhrsw,
vpmulhuw, vpmulhw, vpmulld, vpmullq, vpmullw, vpmultishiftqb, vpmuludq, vpor,
vpord, vporq, vpperm, vprold, vprolq, vprolvd, vprolvq, vprord, vprorq, vprorvd,
vprorvq, vprotb, vprotd, vprotq, vprotw, vpsadbw, vpscatterdd, vpscatterdq,
vpscatterqd, vpscatterqq, vpshab, vpshad, vpshaq, vpshaw, vpshlb, vpshld,
vpshlq, vpshlw, vpshufb, vpshufd, vpshufhw, vpshuflw, vpsignb, vpsignd, vpsignw,
vpslld, vpslldq, vpsllq, vpsllvd, vpsllvq, vpsllvw, vpsllw, vpsrad, vpsraq,
vpsravd, vpsravq, vpsravw, vpsraw, vpsrld, vpsrldq, vpsrlq, vpsrlvd, vpsrlvq,
vpsrlvw, vpsrlw, vpsubb, vpsubd, vpsubq, vpsubsb, vpsubsw, vpsubusb, vpsubusw,
vpsubw, vpternlogd, vpternlogq, vptest, vptestmb, vptestmd, vptestmq, vptestmw,
vptestnmb, vptestnmd, vptestnmq, vptestnmw, vpunpckhbw, vpunpckhdq, vpunpckhqdq,
vpunpckhwd, vpunpcklbw, vpunpckldq, vpunpcklqdq, vpunpcklwd, vpxor, vpxord,
vpxorq, vrangepd, vrangeps, vrangesd, vrangess, vrcp14pd, vrcp14ps, vrcp14sd,
vrcp14ss, vrcp28pd, vrcp28ps, vrcp28sd, vrcp28ss, vrcpps, vrcpss, vreducepd,
vreduceps, vreducesd, vreducess, vrndscalepd, vrndscaleps, vrndscalesd,
vrndscaless, vroundpd, vroundps, vroundsd, vroundss, vrsqrt14pd, vrsqrt14ps,
vrsqrt14sd, vrsqrt14ss, vrsqrt28pd, vrsqrt28ps, vrsqrt28sd, vrsqrt28ss,
vrsqrtps, vrsqrtss, vscalefpd, vscalefps, vscalefsd, vscalefss, vscatterdpd,
vscatterdps, vscatterpf0dpd, vscatterpf0dps, vscatterpf0qpd, vscatterpf0qps,
vscatterpf1dpd, vscatterpf1dps, vscatterpf1qpd, vscatterpf1qps, vscatterqpd,
vscatterqps, vshuff32x4, vshuff64x2, vshufi32x4, vshufi64x2, vshufpd, vshufps,
vsqrtpd, vsqrtps, vsqrtsd, vsqrtss, vstmxcsr, vsubpd, vsubps, vsubsd, vsubss,
vtestpd, vtestps, vucomisd, vucomiss, vunpckhpd, vunpckhps, vunpcklpd,
vunpcklps, vxorpd, vxorps, vzeroall, vzeroupper, wbinvd, wrfsbase, wrgsbase,
wrmsr, wrshr, xabort, xadd, xbegin, xbts, xchg, xcryptcbc, xcryptcfb, xcryptctr,
xcryptecb, xcryptofb, xend, xgetbv, xlat, xlatb, xor, xorl, xorpd, xorps, xrstor,
xrstor64, xrstors, xrstors64, xsave, xsave64, xsavec, xsavec64, xsaveopt,
xsaveopt64, xsaves, xsaves64, xsetbv, xsha1, xsha256, xstore, xtest
	},
	% directives.
	%    ref: http://www.nasm.us/doc/nasmdoc6.html
	keywords=[2]{
ABS, ABSOLUTE, BITS, BND, BYTE, COMMON, CPU, DB, DD, DO, DQ, DT, DW, DWORD, DY,
DZ, EQU, EXTERN, FAR, FLOAT, GLOBAL, LONG, NEAR, NOBND, ORG, QWORD, REL, RESB,
RESD, RESO, RESQ, REST, RESW, RESY, RESZ, SECTALIGN, SECTION, SEG, SEGMENT,
SHORT, STRICT, TIMES, UPPERCASE, USE16, USE32, WORD, WRT,
abs, absolute, bits, bnd, byte, common, cpu, db, dd, do, dq, dt, dw, dword, dy,
dz, equ, extern, far, float, global, long, near, nobnd, org, qword, rel, resb,
resd, reso, resq, rest, resw, resy, resz, sectalign, section, seg, segment,
short, strict, times, uppercase, use16, use32, word, wrt
	},
	% preprocess.
	%    ref: info nasm | grep -o -e "%[a-z]\+" | sort | uniq
	morekeywords=[2]{
\%ARG, \%ASSIGN, \%CLEAR, \%COMMENT, \%DEFINE, \%DEFSTR, \%DEFTOK, \%DEPEND,
\%ELIF, \%ELIFCTX, \%ELIFDEF, \%ELIFEMPTY, \%ELIFENV, \%ELIFID, \%ELIFIDN,
\%ELIFIDNI, \%ELIFMACRO, \%ELIFN, \%ELIFNCTX, \%ELIFNDEF, \%ELIFNEMPTY,
\%ELIFNENV, \%ELIFNID, \%ELIFNIDN, \%ELIFNIDNI, \%ELIFNMACRO, \%ELIFNNUM,
\%ELIFNSTR, \%ELIFNTOKEN, \%ELIFNUM, \%ELIFSTR, \%ELIFTOKEN, \%ELSE,
\%ENDCOMMENT, \%ENDIF, \%ENDM, \%ENDMACRO, \%ENDREP, \%ENDSTR, \%ERROR,
\%EXITREP, \%FATAL, \%IASSIGN, \%IDEFINE, \%IDEFSTR, \%IDEFTOK, \%IF, \%IFCTX,
\%IFDEF, \%IFEMPTY, \%IFENV, \%IFID, \%IFIDN, \%IFIDNI, \%IFMACRO, \%IFN,
\%IFNCTX, \%IFNDEF, \%IFNEMPTY, \%IFNENV, \%IFNID, \%IFNIDN, \%IFNIDNI,
\%IFNMACRO, \%IFNNUM, \%IFNSTR, \%IFNTOKEN, \%IFNUM, \%IFSTR, \%IFTOKEN,
\%IMACRO, \%INCLUDE, \%IXDEFINE, \%LABEL, \%LINE, \%LOCAL, \%MACRO,
\%PATHSEARCH, \%POP, \%PUSH, \%REP, \%REPL, \%ROTATE, \%SKIP, \%STACKSIZE,
\%STRCAT, \%STRLEN, \%SUBSTR, \%UNDEF, \%UNMACRO, \%USE, \%WARNING, \%XDEFINE,
\%arg, \%assign, \%clear, \%comment, \%define, \%defstr, \%deftok, \%depend,
\%elif, \%elifctx, \%elifdef, \%elifempty, \%elifenv, \%elifid, \%elifidn,
\%elifidni, \%elifmacro, \%elifn, \%elifnctx, \%elifndef, \%elifnempty,
\%elifnenv, \%elifnid, \%elifnidn, \%elifnidni, \%elifnmacro, \%elifnnum,
\%elifnstr, \%elifntoken, \%elifnum, \%elifstr, \%eliftoken, \%else,
\%endcomment, \%endif, \%endm, \%endmacro, \%endrep, \%endstr, \%error,
\%exitrep, \%fatal, \%iassign, \%idefine, \%idefstr, \%ideftok, \%if, \%ifctx,
\%ifdef, \%ifempty, \%ifenv, \%ifid, \%ifidn, \%ifidni, \%ifmacro, \%ifn,
\%ifnctx, \%ifndef, \%ifnempty, \%ifnenv, \%ifnid, \%ifnidn, \%ifnidni,
\%ifnmacro, \%ifnnum, \%ifnstr, \%ifntoken, \%ifnum, \%ifstr, \%iftoken,
\%imacro, \%include, \%ixdefine, \%label, \%line, \%local, \%macro,
\%pathsearch, \%pop, \%push, \%rep, \%repl, \%rotate, \%skip, \%stacksize,
\%strcat, \%strlen, \%substr, \%undef, \%unmacro, \%use, \%warning, \%xdefine
	},
	% macros.
	morekeywords=[2]{
ENDSTRUC, IEND, ISTRUC, STRUC,
endstruc, iend, istruc, struc,
	},
	% registers.
	%    ref: http://www.nasm.us/doc/nasmdo11.html#section-11.1
	keywords=[3]{
AH, AL, AX, BH, BL, BP, BPL, BX, CH, CL, CX, DH, DI, DIL, DL, DX, EAX, EBP, EBX,
ECX, EDI, EDX, ESI, ESP, R10, R10B, R10D, R10W, R11, R11B, R11D, R11W, R12,
R12B, R12D, R12W, R13, R13B, R13D, R13W, R14, R14B, R14D, R14W, R15, R15B, R15D,
R15W, R8, R8B, R8D, R8W, R9, R9B, R9D, R9W, RAX, RBP, RBX, RCX, RDI, RDX, RSI,
RSP, SI, SIL, SP, SPL,
ah, al, ax, bh, bl, bp, bpl, bx, ch, cl, cx, dh, di, dil, dl, dx, eax, ebp, ebx,
ecx, edi, edx, esi, esp, r10, r10b, r10d, r10w, r11, r11b, r11d, r11w, r12,
r12b, r12d, r12w, r13, r13b, r13d, r13w, r14, r14b, r14d, r14w, r15, r15b, r15d,
r15w, r8, r8b, r8d, r8w, r9, r9b, r9d, r9w, rax, rbp, rbx, rcx, rdi, rdx, rsi,
rsp, si, sil, sp, spl
	},
}

\definecolor{comment}{RGB}{0,128,0}     % dark green
\definecolor{string}{RGB}{255,0,0}      % red
\definecolor{instruction}{RGB}{0,0,255} % blue
\definecolor{directive}{RGB}{128,0,128} % purple
\definecolor{register}{RGB}{128,0,0}    % dark red

\lstdefinestyle{nasm}{
  language=nasm,
  aboveskip=2mm,
  belowskip=2mm,
	commentstyle=\color{comment},
	stringstyle=\color{string},
	keywordstyle=\color{instruction},
	keywordstyle=[2]\color{directive},
	keywordstyle=[3]\color{register},
	basicstyle=\footnotesize\ttfamily,
	numbers=left,
	numberstyle=\tiny,
	numbersep=5pt,
	breaklines=true,
	showstringspaces=false,
	upquote=true,
	tabsize=4,
}

\usepackage{color}
\usepackage{booktabs}
\usepackage{xcolor}
\usepackage{float}
\usepackage[font=it,labelfont=bf]{caption}
\DeclareCaptionFont{white}{\color{white}}
\DeclareCaptionFormat{listing}{\colorbox{gray}{\parbox{\textwidth}{#1#2#3}}}
\captionsetup[lstlisting]{format=listing,labelfont=white,textfont=white}

\usepackage{fixme} % fixme config
\fxsetup{
  mode=multiuser,
  status=draft,
  margin=false,
  inline=false,
  theme=color,
  layout=pdfnote,
  index=true
}
\FXRegisterAuthor{si}{asi}{Simon}
\FXRegisterAuthor{ka}{aka}{Kasper}
\FXRegisterAuthor{ra}{ara}{Rasmus}
\FXRegisterAuthor{ah}{aah}{Ahmed}
\FXRegisterAuthor{ch}{ach}{Christian}
\FXRegisterAuthor{je}{aje}{Jens}

\usepackage[ % citation support
bibencoding=utf8,
  hyperref=true,
  backend=biber,
  style=ieee,
  sorting=none,
  natbib=true
  ]{biblatex}
  \addbibresource{sources.bib}

\usepackage{csquotes} % recommended by biblatex
\usepackage{lastpage}

\sloppy

% http://tex.stackexchange.com/questions/42063/illogical-twoside-margins
% layout page auto-centering horizontally and allow for press binding
\usepackage[hcentering,bindingoffset=8mm]{geometry}

\usepackage{hyperref} % hyperlinks in pdf
\usepackage{cleveref} % clever references. Use with \cref...
\let\origref\cref
\def\cref#1{\emph{\origref{#1}}}
\let\Origref\Cref
\def\Cref#1{\emph{\Origref{#1}}}

\usepackage{fancyvrb}

  % ¤¤ Kapiteludssende ¤¤ %
\usepackage{titlesec}
\titleformat{\chapter}
  {\normalfont\LARGE\bfseries}{\thechapter}{1em}{}
\titlespacing*{\chapter}{0pt}{-2ex}{0ex}

\let\Oldpart\part
\newcommand{\parttitle}{}
\renewcommand{\part}[1]{\Oldpart{#1}\renewcommand{\parttitle}{#1}}

\usepackage{fancyhdr}
\usepackage{nopageno}
\setlength{\headheight}{52pt}

\fancypagestyle{fancyplain}{} % no ordinary headers and footers in pages with chapters
\fancyhead{} % clear default header
\fancyfoot{} % clear default footer

\renewcommand{\chaptermark}[1]{\markboth{\thechapter.\space#1}{}} % do not print "chapter"

\fancypagestyle{BasicStyle}{
	\fancyhead[OL, ER]{
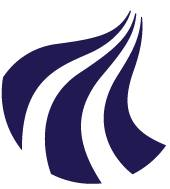
[picture p10: Report/aau_logo_cropped.png]
		\parbox{17mm}{{}}\parbox{45mm}{\textsc{Aalborg University}\\\textit{sw501e15}}}
	\fancyhead[OR, EL]{\parbox{56mm}{\nouppercase{{\textsc{\parttitle}} \\ \leftmark}}}

	\fancyfoot[OR, EL]{Page {\thepage} of \pageref{LastPage}}
	\fancyfoot[OL, ER]{December 21\textsuperscript{st}, 2015}
}

\pagenumbering{roman}
\pagestyle{empty} % Use empty at first
\setlength{\belowcaptionskip}{-12pt}
\raggedbottom
\hyphenation{fa-brik-ken}

%%%%%%%%%% macros
\newcommand*{\blankpage}{
\vspace*{\fill}
\begin{center}
\textit{This page intentionally left (almost) blank.}\thispagestyle{empty}
\end{center}
\vspace{\fill}}

\makeatletter
% start with some helper code
% This is the vertical rule that is inserted
\newcommand*{\algrule}[1][\algorithmicindent]{\makebox[#1][l]{\hspace*{.5em}\vrule height .75\baselineskip depth .25\baselineskip}}%

\newcount\ALG@printindent@tempcnta
\def\ALG@printindent{%
    \ifnum \theALG@nested>0% is there anything to print
        \ifx\ALG@text\ALG@x@notext% is this an end group without any text?
            % do nothing
            \addvspace{-1pt}% FUDGE for cases where no text is shown, to make the rules line up
        \else
            \unskip
            % draw a rule for each indent level
            \ALG@printindent@tempcnta=1
            \loop
                \algrule[\csname ALG@ind@\the\ALG@printindent@tempcnta\endcsname]%
                \advance \ALG@printindent@tempcnta 1
            \ifnum \ALG@printindent@tempcnta<\numexpr\theALG@nested+1\relax% can't do <=, so add one to RHS and use < instead
            \repeat
        \fi
    \fi
    }%
% the following line injects our new indent handling code in place of the default spacing
\patchcmd{\ALG@doentity}{\noindent\hskip\ALG@tlm}{\ALG@printindent}{}{\errmessage{failed to patch}}
\makeatother
% end vertical rule patch for algorithmicx

\renewcommand{\algorithmicforall}{\textbf{for each}}

\def\mypart#1#2{%
\refstepcounter{part}% Next part
\addcontentsline{toc}{part}{\thepart~#1}
\par\newpage\clearpage % Page break
\vspace*{5cm} % Vertical shift
{\centering \textbf{\Huge Part \thepart}\par}\thispagestyle{empty}%
\vspace{1cm}% Vertical shift
{\centering \textbf{\Huge #1}\par}%
\vspace{2cm}% Vertical shift %
\noindent #2
\vfill\pagebreak % Fill the end of page and page break
}
