simonvandel/AHA/Report/titlepage.tex

%mainfile: master.tex
\markboth{Titlepage}{Titlepage} % Add to header

\begin{nopagebreak}
{\begin{center}
    \begin{tabular*}{\textwidth}{@{}l@{\extracolsep{\fill}}r@{}}
        \multicolumn{2}{@{}l@{}}{
            \begin{minipage}[t]{1.0\textwidth}
            \vspace{0.3cm}
            \end{minipage}
        }\\
        \begin{minipage}[t]{0.49\textwidth}
            \textbf{Title}\\
            AHA - Automated Home Automation\\

            \textbf{Themes}\\
            Embedded software, artificial intelligence, home automation\\

            \textbf{Project Period}\\
            Autumn semester 2015\\

            \textbf{Project Group}\\
            sw501e15\\

            \textbf{Participants}\\
            Christian Heider Nielsen\\
            Jens Hegner Stærmose\\
            Kasper Fuglsang Christensen\\
            Rasmus Bak Christiansen\\
            Simon Vandel Sillesen\\
            Zobair Qauomi\\

            \textbf{Supervisor}\\
            Giovanni Bacci\\

            \textbf{Copies}\\
            2\\ % https://www.moodle.aau.dk/course/view.php?id=8838

            \textbf{Number of Pages}\\
            \pageref{LastPage}\\

        \end{minipage}
        &
\begin{minipage}[t]{0.49\textwidth}
\begin{flushright}
    \\
        \small \textbf{Software - 5\textsuperscript{th} semester} \\
        \small \textbf{Department of Computer Science}\\
        \small Selma Lagerlöfs Vej 300 \\
        \small 9220 Aalborg Ø\\
        \small \url{http://www.cs.aau.dk/}\\
        \bigskip
        \fbox{
            \parbox{\linewidth}{
            {\input{synopsis.tex}
            }
        }}
\end{flushright}
\end{minipage}

        \\
    \end{tabular*}
\end{center}
}
\end{nopagebreak}
\newpage
