simonvandel/AHA/Report/Specification/functions.tex

\section{Functions}\label{sec:functions}
This section explores functions, which the system should support, in order to solve the requirements presented in \cref{sec:requirements}, along with creating the basis for designing information management. The method for describing these functions is based on Object Oriented Analysis \& Design\cite{OOAD}.

In \cref{table:functionlist}, each function is described as an action, that the system can take, or information, which the system has access to. Each function also has two attributes. \enquote{Complexity} is an estimate of how complex the development of the function will be. \enquote{Type} describes what the function does in the system\cite{OOAD}.

\begin{table}[hbtp]
\centering
\begin{tabular}{lcr}
\toprule
\textbf{Name}																& \textbf{Complexity}	& \textbf{Type} \\
\midrule
User turns lights off/on				& Simple	& Update  \\
User dims lights					& Simple	& Update  \\
User turns off/on appliances			& Simple	& Update  \\
User marks behaviour as wrong			& Simple	& Update  \\
Change in light intensity in the room		& Simple	& Update  \\
System turns off/on lights			& Simple	& Signal  \\
System dims lights				& Simple	& Signal  \\
System turns off/on appliances			& Simple	& Signal  \\
Appliance is on standby				& Medium	& Update  \\
User enters room				& Medium	& Update  \\
User leaves room				& Medium	& Update  \\
Find user location			& Complex	& Compute \\
Calculate behavioural rules for the system	& Complex	& Compute \\
\bottomrule
\end{tabular}
\caption[Function table]{Function table that describes each function the system should have}
\label{table:functionlist}
\end{table}

The system is able to register input from multiple sensors. Using these different sensors the system is able to find the specific placement of the user in the room. Bundled into one function called \enquote{Find user location}. The function is of the type \enquote{Compute} because it solves an information need. Because the function requires the analysis of multiple different data points the complexity is approximated to be complex.

The \enquote{User enters room} function is of type \enquote{Update} because it's activated by a change in the problem domain and presents a model change in the system. This function is marked as having medium complexity, because it is estimated that the simplest approach to this problem will not be sufficiently precise to solve the problem.

The system uses its sensor inputs together with its general knowledge of the world to analyse the behavioural patterns of the user and find out when and how the user uses his lights and appliances. This analysis sets up the rules for the actuators in the system so they can eventually perform the tasks for the user, e.g. the user always turns off his or her lights, when he leaves the room at 07:45; when this pattern has been found the system starts automatically turning off the lights.
