simonvandel/AHA/Report/Implementation/photoResistorExperiments.tex

\subsection{Experiments}
In order to find out relevant properties of the two photoresistors, some experiments were conducted. The goals of the experiments are the following:

\begin{itemize}
  \item Determine the precision of the sensor
  \item Find the ideal configuration of resistors in a generic use-case scenario
\end{itemize}

\subsubsection{Precision}\label{subsub:precision}
To test the precision of the photoresistors, an experiment was designed.
\paragraph{Hypothesis}
It was expected that the photoresistors would exhibit some imprecision, as they were cheap, amateur-grade resistors.
\paragraph{Test Procedure}
To test the precision of the photoresistors, they were put through three different tests. In each test, the resistors were exposed to constant light. Under these constant light conditions, many readings were taken from the resistors, in order to find the variance which they exhibited.
The tests varied in the amount of light exposed to the resistors. The light levels for the tests are the following:

\begin{description}
  \item[Minimal light]
  This scenario was constructed by placing the resistors under a staircase, in a room with only low ambient light from a normal office hallway.
  \item[Average room light]
  This scenario was constructed by placing the resistors in a small, empty room with no windows, with a single light bulb lit.
  \item[Intense light]
  This scenario was constructed by aiming a flashlight directly at the resistors at point blank range.
\end{description}

To record the readings from the resistors, the code in \cref{lst:arduinoPhotoCode} was used for the Arduino. This program simply reads the value from the two sensors and prints it to the serial output, which in this case was a connected computer.

This program was run until more than 1000 readings were taken in each scenario.
To find the minimum, maximum and average values, as well as the difference between maximum and minimum in percent. The data was copied into a file, which was then input to the C\#-program seen in \cref{lst:cShPhotoCode}.

\paragraph{Results}
The results of the tests can be seen in \cref{tab:precisionTestResults}. "S1" refers to the first photoresistor. and "S2" refers to the second.

  \begin{table}[htbp]
    \centering
    \begin{tabular}{*{9}{c}}
      \toprule
      Scenario & \multicolumn{4}{c}{S1} & \multicolumn{4}{c}{S2} \\
      \cmidrule(rl){2-5} 
      \cmidrule(rl){6-9}
       & min & max & avg & diff & min & max & avg & diff \\ \midrule
      Minimum light & 136 & 138 & 137 & 1,47 \% & 25 & 27 & 26 & 8.00 \% \\
      Average room light & 875 & 889 & 883 & 1,60 \%  & 634 & 675 & 656 & 6,47 \% \\
      Intense light & 931 & 933 & 932 & 0,21 \%  & 772 & 775 & 773 & 0,39 \% \\ \bottomrule
    \end{tabular}
    \caption[Precision test results]{Precision test results. "S1" refers to the first photoresistor. and
      "S2" refers to the second. The min, max and avg values range from 0 to 1023.}\label{tab:precisionTestResults}
  \end{table}

\paragraph{Partial Conclusion}
The results of the tests can be seen in \cref{tab:precisionTestResults}. As can be seen in the table S2 had a significant lower base value. This means it will be better at detecting higher levels of light.

\subsubsection{Configuration}
In order fully take advantage of the two photoresistors, an experiment was devised to find a configuration of pull-down resistors, which would offer a large range of meaningful values, i.e. be able to detect small differences under low light as well as intense light scenarios.
\paragraph{Hypothesis}
Using different pull-down resistors on the photoresistors would make it possible to extend the range of values, which the sensor pair could register.
\paragraph{Test Procedure}
The scenarios described in \cref{subsub:precision} are also used in this experiment. Between each set of scenarios, a pull-down resistor value was changed. As the 10K $\Omega$ resistor used in the previous experiments responded well to low light conditions, and was almost impossible to bottom out, another resistor-value was sought which could complement this. To increase the tolerance to light, available resistors with less resistance than 10K $\Omega$ have been investigated.
\paragraph{Results}
The results from the configuration experiments can be seen in \cref{tab:1KTestResults,tab:2.2KTestResults,tab:4.4KTestResults,tab:10KTestResults,tab:12.2KTestResults}.

\begin{table}[htbp]
  \centering
  \begin{tabular}{c c c c c}
    \toprule
    Scenario & min & max & avg & diff \\ \midrule
    Minimum light & 0 & 0 & 0 & 0.00 \% \\
    Average room light & 16 & 18 & 17 & 12.50 \% \\
    Intense light & 406 & 408 & 406 & 0.49 \% \\ \bottomrule
  \end{tabular}
  \caption[1K $\Omega$ resistor results]{1K $\Omega$ resistor results. The min, max and avg values range from 0 to 1023.}\label{tab:1KTestResults}
\end{table}

\begin{table}[htbp]
  \centering
  \begin{tabular}{c c c c c}
    \toprule
    Scenario & min & max & avg & diff \\ \midrule
    Minimum light & 0 & 0 & 0 & 0.00 \% \\
    Average room light & 49 & 58 & 53 & 18.37 \% \\
    Intense light & 609 & 612 & 610 & 0.49 \% \\ \bottomrule
  \end{tabular}
  \caption[2.2K $\Omega$ resistor results]{2.2K $\Omega$ resistor results. The min, max and avg values range from 0 to 1023.}\label{tab:2.2KTestResults}
\end{table}

\begin{table}[htbp]
  \centering
  \begin{tabular}{c c c c c}
    \toprule
    Scenario & min & max & avg & diff \\ \midrule
    Minimum light & 7 & 11 & 11 & 57.14 \% \\
    Average room light & 282 & 287 & 284 & 1.77 \% \\
    Intense light & 893 & 895 & 894 & 0.22 \% \\ \bottomrule
  \end{tabular}
  \caption[4.4K $\Omega$ resistor results]{4.4K $\Omega$ resistor results. The min, max and avg values range from 0 to 1023.}\label{tab:4.4KTestResults}
\end{table}

\begin{table}[htbp]
  \centering
  \begin{tabular}{c c c c c}
    \toprule
    Scenario & min & max & avg & diff \\ \midrule
    Minimum light & 136 & 138 & 137 & 1.47 \% \\
    Average room light & 875 & 889 & 883 & 1.60 \% \\
    Intense light & 931 & 933 & 932 & 0.21 \% \\ \bottomrule
  \end{tabular}
  \caption[10K $\Omega$ resistor results]{10K $\Omega$ resistor results. The min, max and avg values range from 0 to 1023.}\label{tab:10KTestResults}
\end{table}

\begin{table}[htbp]
  \centering
  \begin{tabular}{c c c c c}
    \toprule
    Scenario & min & max & avg & diff \\ \midrule
    Minimum light & 44 & 52 & 51 & 18.18 \% \\
    Average room light & 592 & 622 & 606 & 5.07 \% \\
    Intense light & 979 & 982 & 980 & 0.31 \% \\ \bottomrule
  \end{tabular}
  \caption[12.2K $\Omega$ resistor results]{12.2K $\Omega$ resistor results. The min, max and avg values range from 0 to 1023.}\label{tab:12.2KTestResults}
\end{table}

\paragraph{Partial Conclusion}
Using a 12.2K pull-down resistor on one photoresistor and a 4.4K pull-down resistor on the other allows for good precision both in darker and lighter environments, because one photoresistor is very sensitive to low light conditions and very tolerant of intense light conditions, and the other is the inverse. This pairing seems more than adequate for the purpose in this project.
