simonvandel/AHA/TestResults/TimingTest/TimingResults.txt

Best case:
124
125
125
124
125
122
125
122
126
125

Worst case:
272
270
271
268
271
273
274
271
270
277
274
273
