simonvandel/AHA/Report/Implementation/PhotoSensorTests/PhotoTest.txt

Højt lys, mobil;
a0Avg = 932
a0Min = 931
a0Max = 933
a0Diff = 0,214822771213747%
a1Avg = 773
a1Min = 772
a1Max = 775
a1Diff = 0,388601036269435%

Stadard kontor-rum lampe, kopirum;
a0Avg = 883
a0Min = 875
a0Max = 889
a0Diff = 1,59999999999999%
a1Avg = 656
a1Min = 634
a1Max = 675
a1Diff = 6,46687697160884%

Lavt lys, kun "ambient" lys, under trappe;
a0Avg = 137
a0Min = 136
a0Max = 138
a0Diff = 1,47058823529412%
a1Avg = 26
a1Min = 25
a1Max = 27
a1Diff = 8%

Under trappe. Lavt til ekstremt lys, med 10k modstand på a0 og 880 modstand på a1;
a0Avg = 538
a0Min = 37
a0Max = 970
a0Diff = 2521,62162162162%
a1Avg = 109
a1Min = 0
a1Max = 712
a1Diff = INF%

Kopirum. Mørke til normalt kontor lys, med 10k a0 og 880 a1;
a0Avg = 513
a0Min = 2
a0Max = 836
a0Diff = 41700%
a1Avg = 57
a1Min = 0
a1Max = 104
a1Diff = INF%

Under trappe. Ekstremt lys;
a0Avg = 947
a0Min = 946
a0Max = 948
a0Diff = 0,211416490486258%
a1Avg = 430
a1Min = 430
a1Max = 432
a1Diff = 0,465116279069775%

Under trappe. mørk ambient;
a0Avg = 60
a0Min = 54
a0Max = 62
a0Diff = 14,8148148148148%
a1Avg = 0
a1Min = 0
a1Max = 0
a1Diff = NaN%

Kopirum, normalt lys;
a0Avg = 903
a0Min = 897
a0Max = 910
a0Diff = 1,44927536231884%
a1Avg = 288
a1Min = 270
a1Max = 307
a1Diff = 13,7037037037037%
