simonvandel/AHA/Report/Images/Usecases.pdf

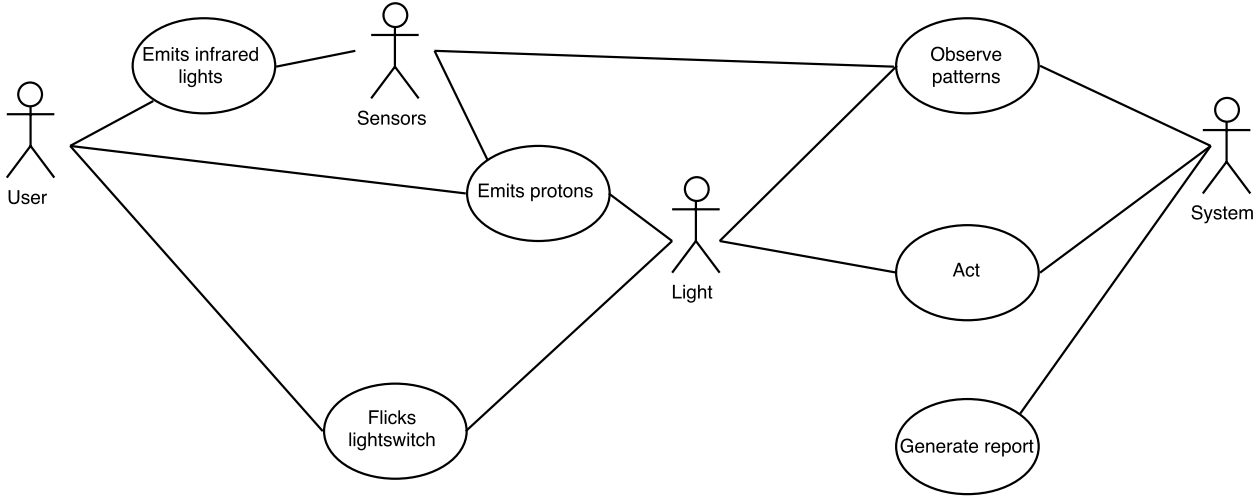
[picture p11: page 1]
