simonvandel/AHA/Report/Images/Behaviour.pdf

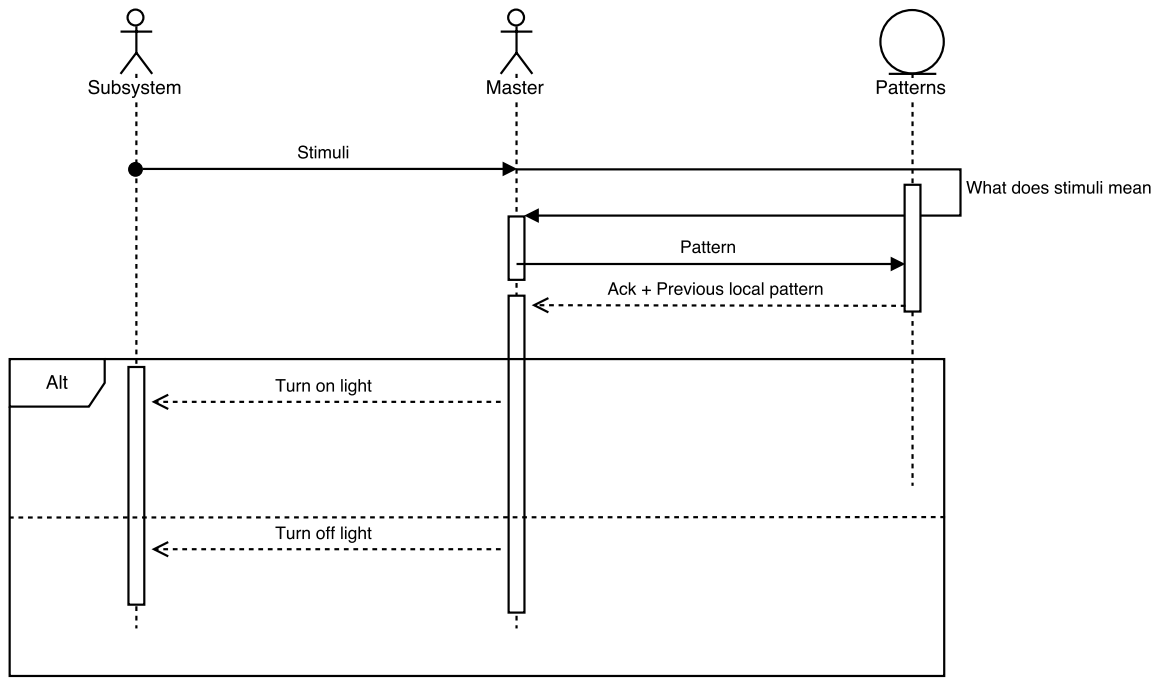
[picture p12: page 1]
