simonvandel/AHA/Report/Images/Structure.pdf

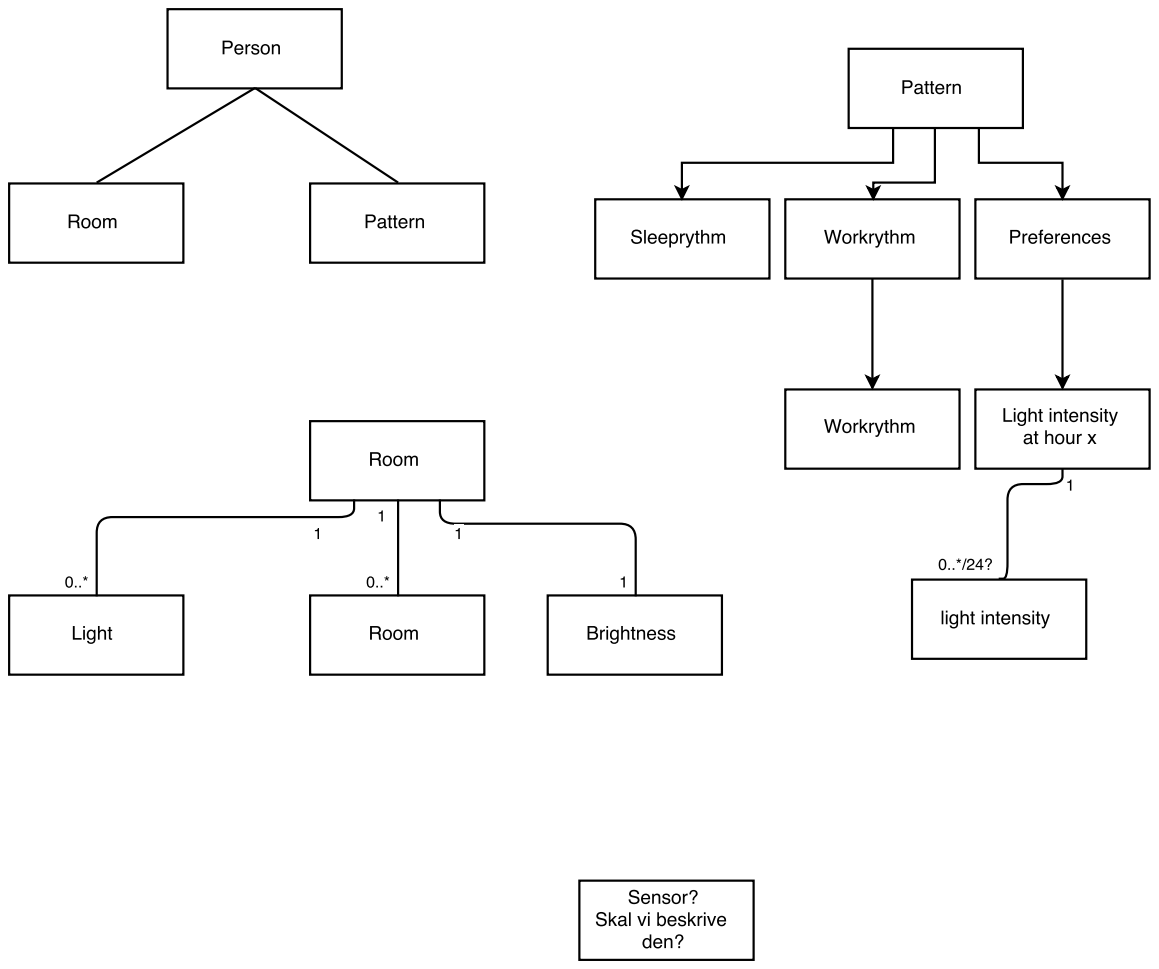
[picture p13: page 1]
