simonvandel/AHA/(commit log)

2015-09-17 Tilføj latexmkrc fil, så latemk ved at det er pdf filer der skal laves
2015-09-22 pir arduino code
2015-09-22 update preamble
    * change fixme users to reflect current group members
    * delete redundant code
2015-09-28 Add graphics path to preamble so images can be inserted by their filename without path
2015-09-28 hardware: Add figure of pir sensor wiring
2015-09-28 explain sampling algorithm for pir sensor
2015-09-28 travis: screw biber. We do not need it to test if it builds anyway
2015-09-28 Fix input af problemformulering så der kan kompileres
2015-10-07 PIR-sensor corrections
2015-10-07 Add point about aggregation of multiple sensor data with a monolithic system
2015-10-12 Correction of Pir-sensor is done.
2015-10-12 Do not track .lox files
2015-10-12 Do not track .el files and .DS_Store files
2015-10-14 Fix compilation error and include in design
    [arduinoProgram.ino]
2015-10-14 do not track master.lox
2015-10-15 review photo sensor
2015-10-21 fjern fil der ikke skal med
2015-10-23 rephrase optimal amount of sensors
2015-10-28 Arduino explorer fixes
2015-10-29 Arduino Exprorer Get and Set works
2015-10-29 Ultrasonic sub
2015-10-30 Ultrasonic branch
2015-10-30 Not Another PACT Rettelse: Forklar hvad pact står for Dont use paragraph-header as part of sentence do da format rephrase optimal amount of sensors sammentrækninger væk user's -> users' fysisk handik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
2015-11-02 Ultrasonic test added
2015-11-04 Arduino Xbee latency test lib
2015-11-07 Ultrasonic concluded
2015-11-09 fjern note omkring hypothesis, da der står forklaret hvad hypothesis er
2015-11-10 review ultrasonic
2015-11-12 update sensordata (lidt)
2015-11-15 start på målestation.
    - biblioteker til vores sensorer (ultralyd havde)
    - mangler:
    - Xbee integration
    - encode sensorværdier og send afsted
    -
2015-11-17 arduino: put measurements in packet to send to master
2015-11-21 do not track out dir
2015-11-21 COM part done i think. I have only tested via some unit tests, so probably not bugfree
    [Main.java]
2015-11-22 Added complete SensorStation
    Too difficult testing without the explorer-module
2015-11-24 fix maven dependencies and new structure
    [Main.java]
2015-11-24 add deviceAddress and sensorIndexOnDevice to SensorValue class
2015-11-26 Changed Normalizer
    Normalizes across sensor history instead of sensor state snapshot
2015-11-28 Added send function to Com
    Might need to use AsynchSend or use a seperate thread
2015-11-30 start on learner. Still many things to do. This just lays some groundwork
2015-12-02 Sanitiser (part of sampler) first commit. Still need to update DB
2015-12-03 Sampler now adds sanitised samples to DB
2015-12-04 Arduino sensor station possible change
2015-12-04 Cache tuning in Reasoner and Sampler
2015-12-04 Fixed singleton pattern in Sampler and DB. Complete with totally arbitrary arguments
2015-12-04 Tested and minior fixes
    [Main.java]
2015-12-07 send correct data from calculateReasoning and make findActions return all emulatable sensor changes even if they have not changeed
2015-12-07 Added Com to Reasoner, fixed errors from merging
    [Main.java]
2015-12-07 Implemented learner thread
2015-12-07 Main loop done, minor fixes and additions
    added learner thread spawn and handle in main, cleaned up main. changed
    mean to average in findNumberOfClusters in modelgenerator. Runs
    normalize on first set of data in normalize
    [Main.java]
2015-12-07 Revert "Main loop done, minor fixes and additions"
    This reverts commit d2c3c00c2d4fc900d1035571ded8282b91efeca1.
    [Main.java]
2015-12-07 Revert "Revert "Main loop done, minor fixes and additions""
    This reverts commit 8c04eea3076cfcfd5a61b9e8bf2c555e84025cba.
    [Main.java]
2015-12-07 arduino serialization af actions
2015-12-09 Decode message - actuators missing
    [SensorStation.ino]
2015-12-09 Main got fucked, reverted to commit: f61e355
    Minor spelling in T&V
    [Main.java]
2015-12-09 SensorStation: Act on received actions
2015-12-09 Serialization possibly works on arduino
2015-12-09 Yo heider fix your merge skills
    Returned main to functional state
    [Main.java]
2015-12-10 db done for sensorstate
2015-12-10 No db, use samplelist
2015-12-10 Arduino test photores + kontakt
2015-12-10 samplelist ffs
2015-12-11 Error on arduino connstant and logging changes for server
    [Main.java]
2015-12-13 Implemented new DB call
    Now saves all sensor states when received, and restores them all before
    the main loop starts
2015-12-13 added null check for db data restore
    And moved up before we register it to the queue to the comm, to avoid
    any possible conflicts
    [Main.java]
2015-12-14 Sampler include
2015-12-15 SensorStation send print update
2015-12-15 Sampler reviewed
2015-12-15 Arduino warning removals
2015-12-16 change sensor smoothing again
2015-12-16 sensorstation begun
2015-12-16 sensorstation expanded
2015-12-16 sensorstation expanded even more
2015-12-17 noter om hvordan sensorer sampler data
2015-12-17 Sensorstation is corrected
2015-12-17 flyt udregninger fra sensor station til xbee
2015-12-17 målinger sensorer
2015-12-17 Three boolean sensors and cleanup in sensorstation
2015-12-17 noget der virker
2015-12-17 fix takeFeedback. Nu skal takeFeedback bare også kaldes når vi laver feedback
    [Main.java]
2015-12-18 stray bracket caused by severe lack of caffeine
2015-12-18 sensor/actuator til embedded subsystem relevante steder
2015-12-18 timing tests with no interrupts
2015-12-18 Sampler and HMM is corrected a little bit. Kanote eleminated.
2015-12-18 fix note in ultrasonic
2015-12-18 sensor station corrections
2015-12-18 null all over, and timer et eller andet
2015-12-19 sample log without xml for input to tests.tex
2015-12-19 AI adaption fix and second sensor station
    [Main.java, SensorStation2.ino]
2015-12-20 clarify what worst and best case in tests is
2016-01-15 failed attempt at test with analog sensor
    [SensorStation.ino]
